w0ts/jank/hardware/box/renders/back.png

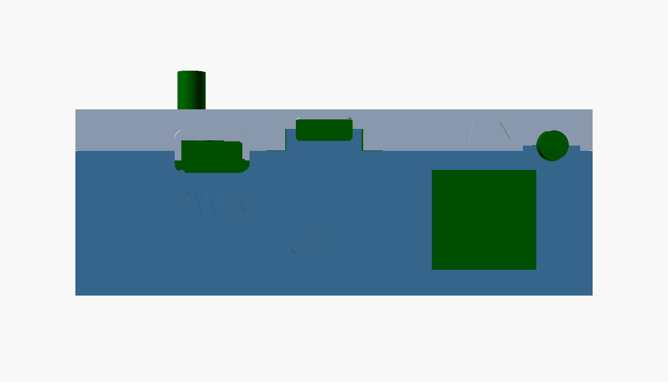
hardware/box/renders/back.png
