w0ts/jank/hardware/box/renders/box.png

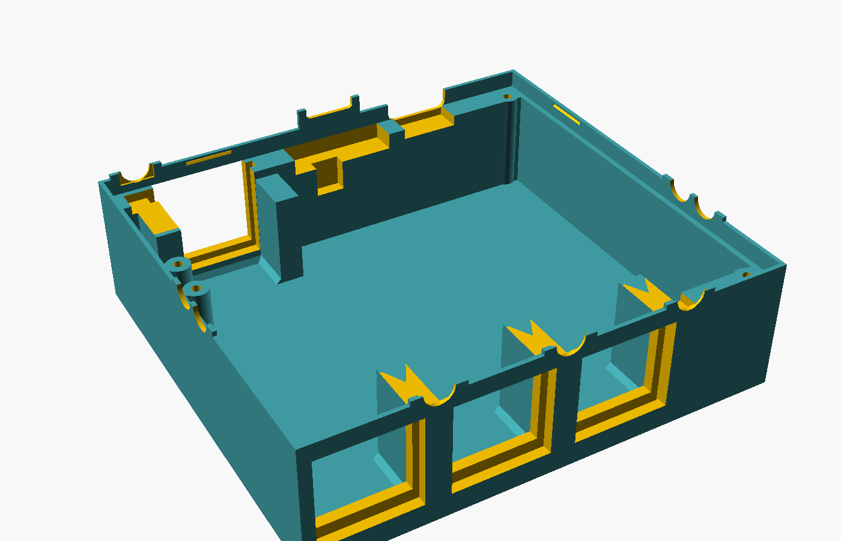
hardware/box/renders/box.png
