w0ts/jank/hardware/box/renders/caps.png

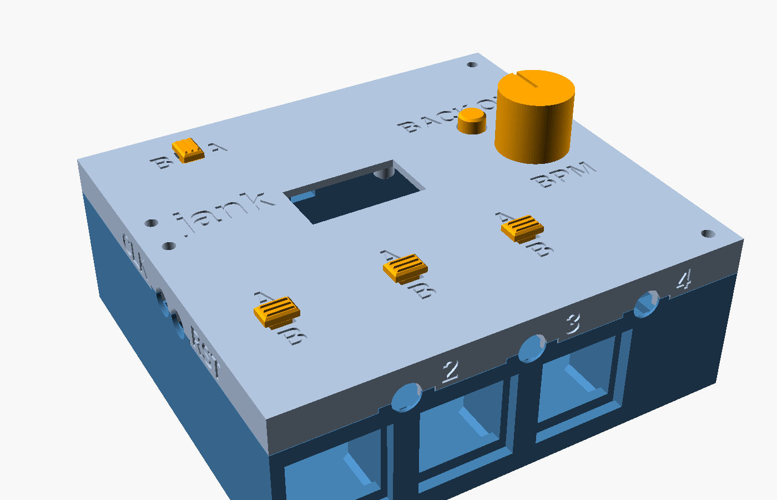
hardware/box/renders/caps.png
