w0ts/jank/hardware/box/renders/front.png

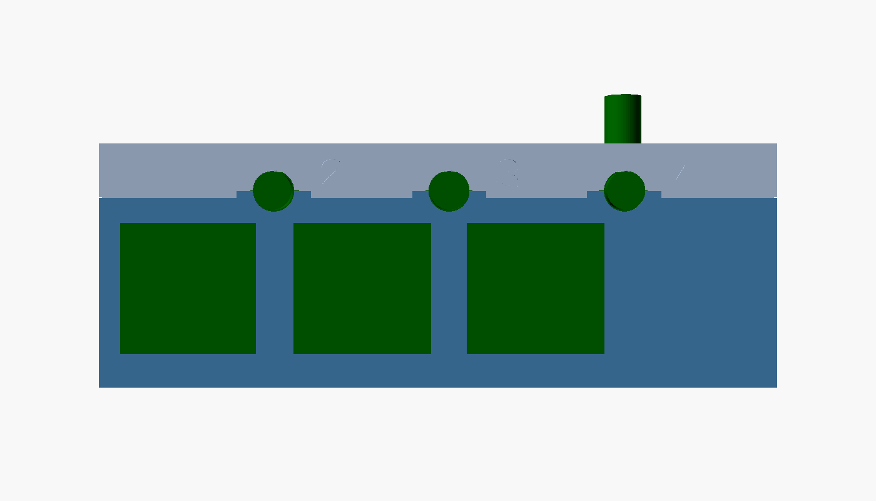
hardware/box/renders/front.png
