w0ts/jank/hardware/box/renders/joint.png

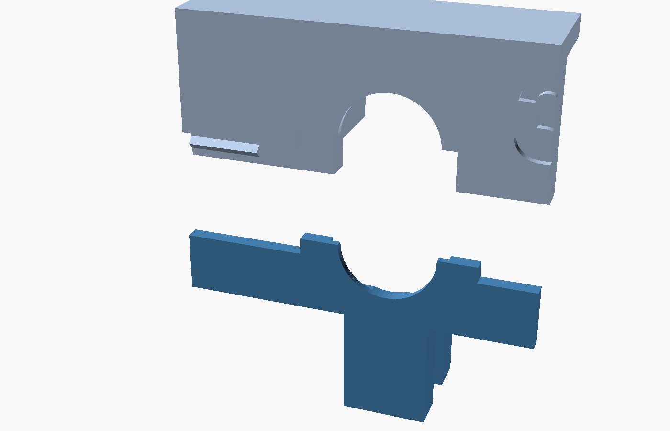
hardware/box/renders/joint.png
