w0ts/jank/hardware/box/renders/left.png

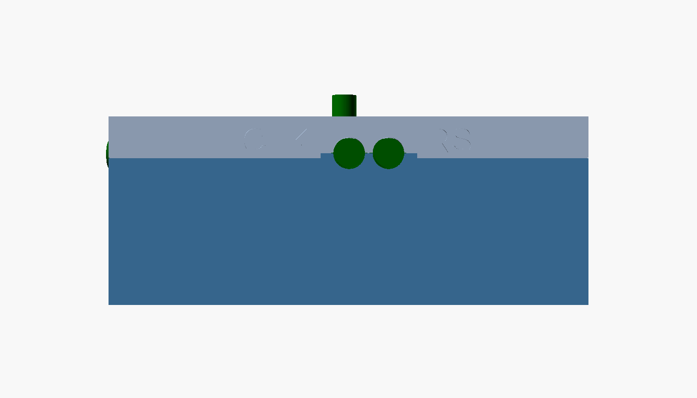
hardware/box/renders/left.png
