w0ts/jank/hardware/box/renders/lid_top.png

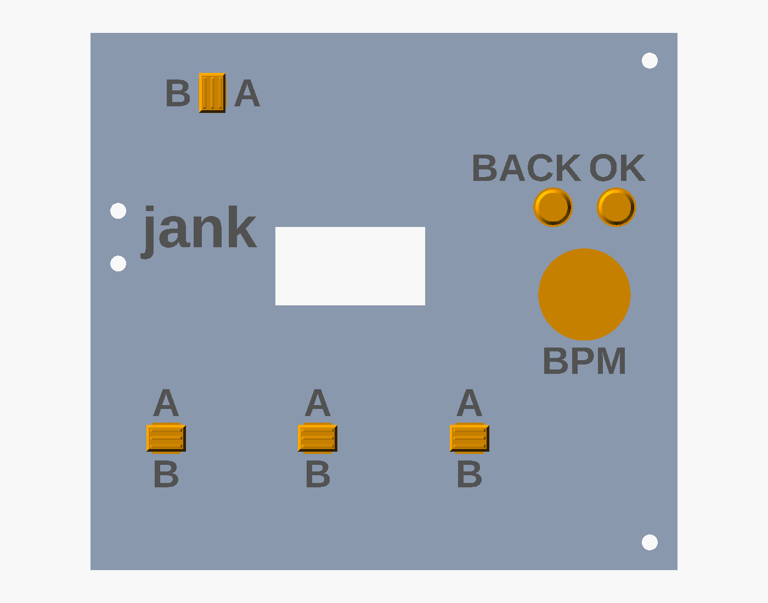
hardware/box/renders/lid_top.png
