w0ts/jank/hardware/box/renders/lid_underside.png

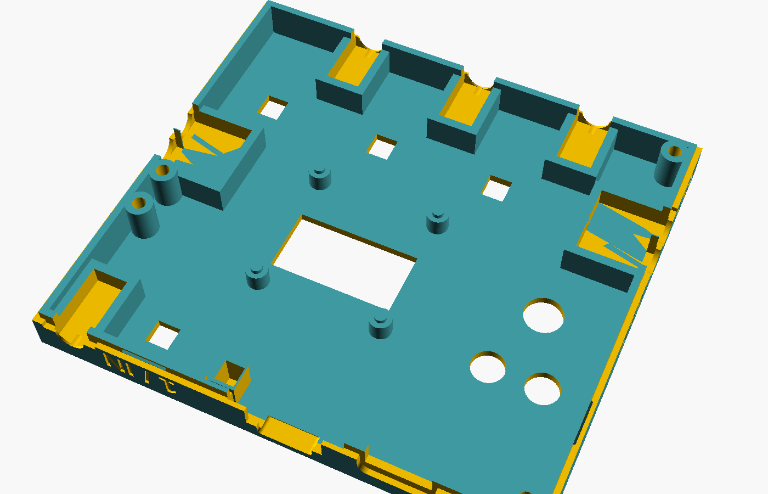
hardware/box/renders/lid_underside.png
