w0ts/jank/hardware/box/renders/right.png

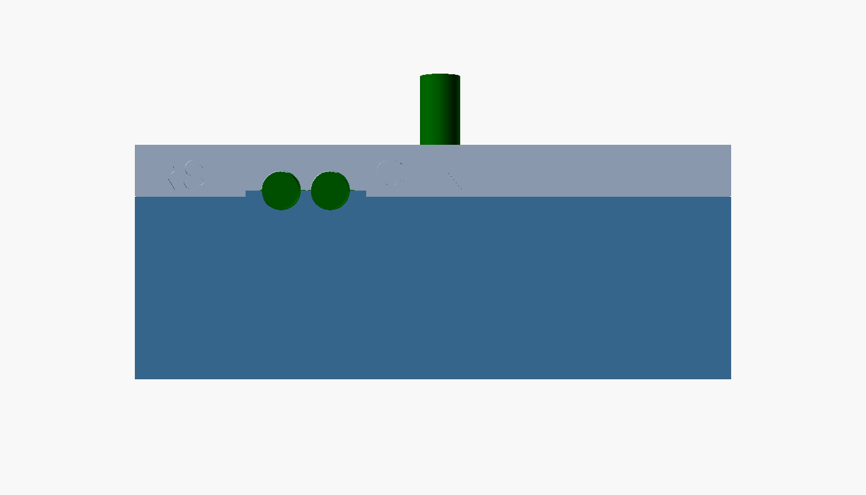
hardware/box/renders/right.png
