w0ts/jank/hardware/box/renders/tab.png

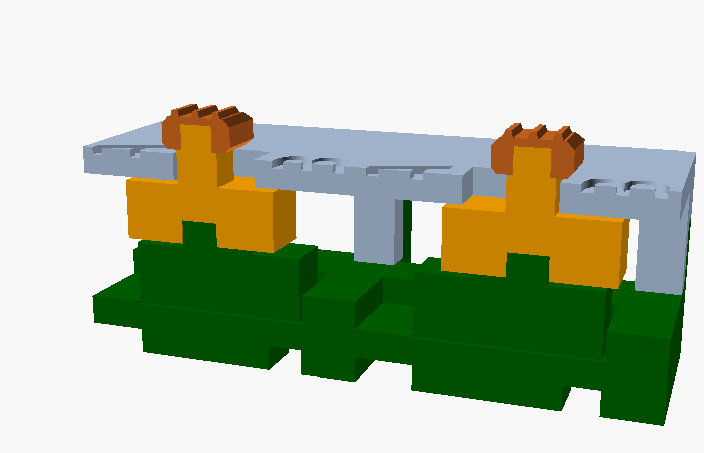
hardware/box/renders/tab.png
