w0ts/jank/hardware/pcb/render-bottom-mod.png

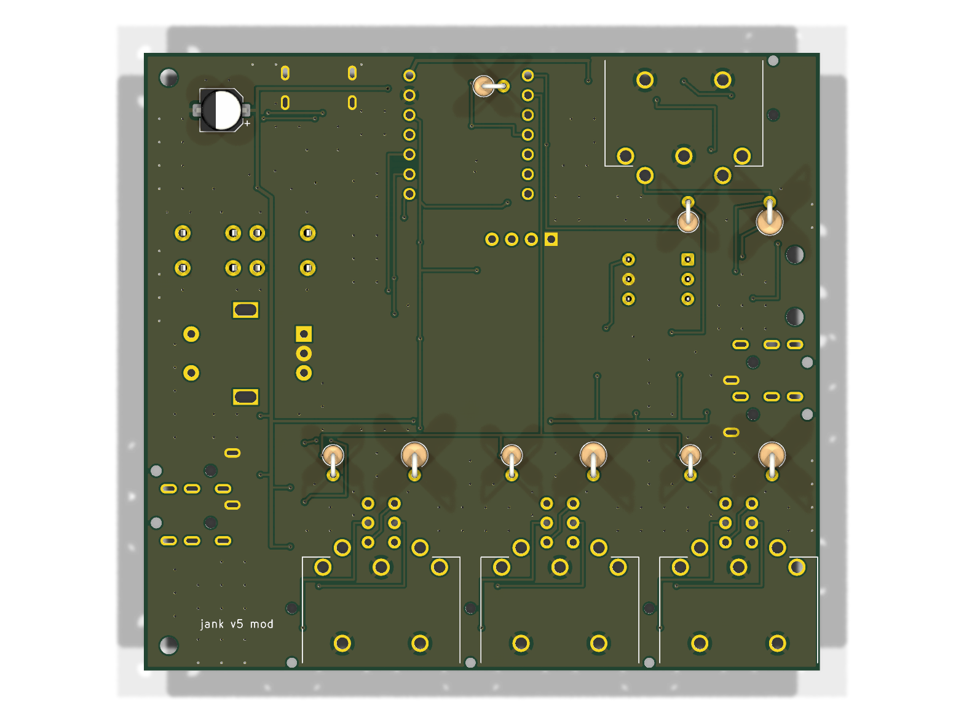
hardware/pcb/render-bottom-mod.png
