w0ts/jank/hardware/pcb/render-bottom.png

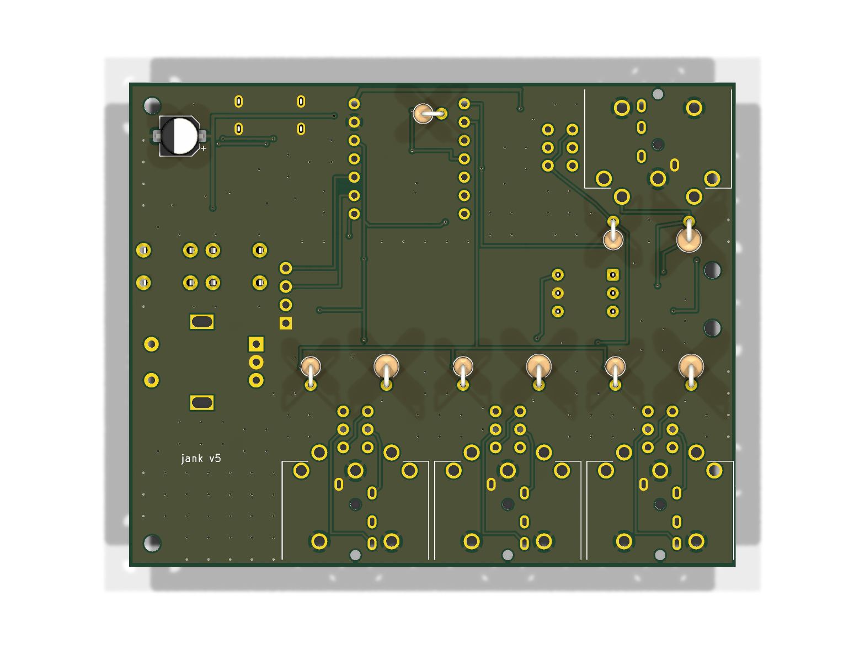
hardware/pcb/render-bottom.png
