w0ts/jank/hardware/pcb/render-top.png

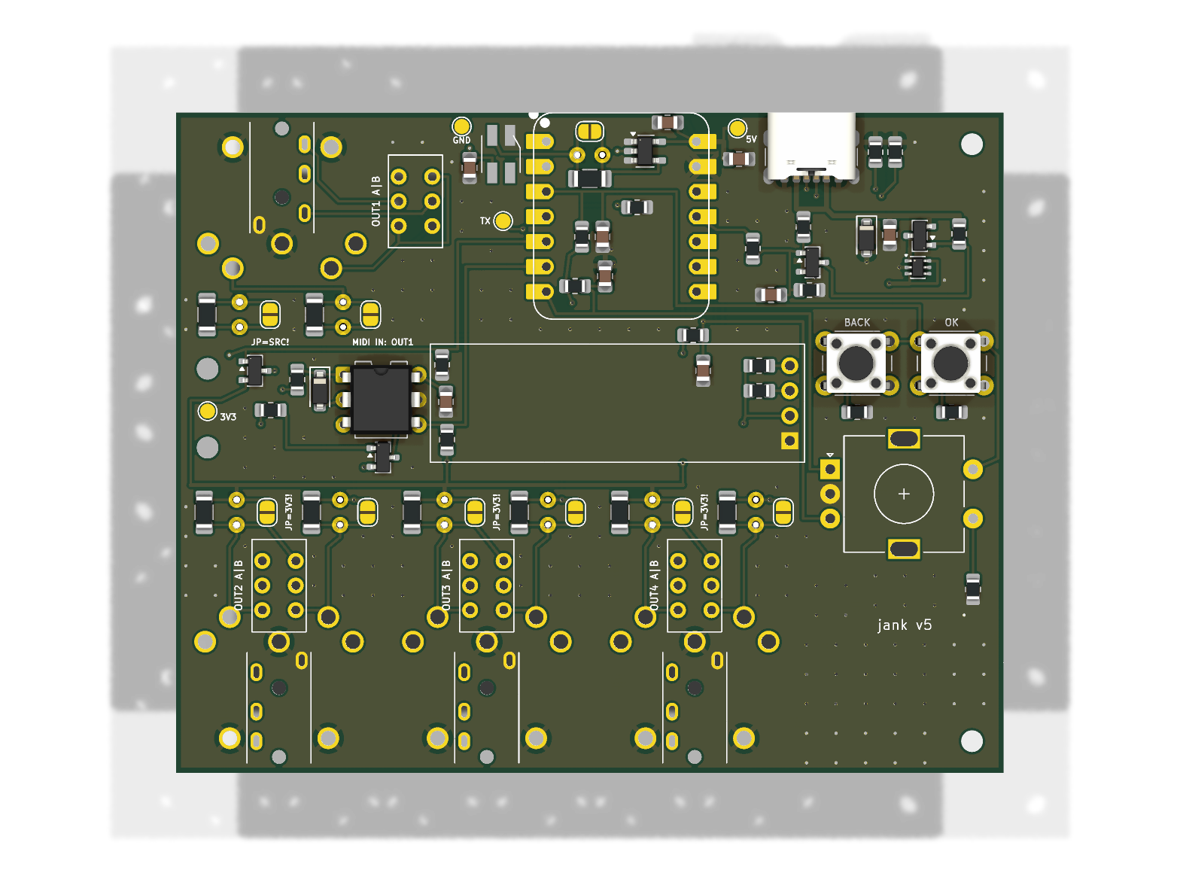
hardware/pcb/render-top.png
