w0ts/jank/hardware/pcb/BOM-mod.md

# jank board (modular variant): bill of materials

Generated by `make_schematic.py`. One price each, read on 2026-11-08 from the shop named, at its first price break, before VAT and shipping. LCSC prices come from LCSC's own product data (USD). Nothing here was ordered.

v5: every output has BOTH connectors fitted, the 3.5 mm jack on the top and the DIN-5 on the bottom (in parallel,
plug one at a time), and its TRS A/B switch. One board: 4 jacks, 4 DINs, 4 A/B switches, the OLED, one LED. **Modular variant** (`jank-pcb-mod`): plus 4 mono jacks (CLOCK / RESET, both side walls), the PCF8574T, 4 buffers, 4 x 1 k, 4 BAT54S, 5 x 100 nF.

| Refs | Qty | Part | MPN | Shop, code | Unit | Min order |
|---|---|---|---|---|---|---|
| U1 | 1 | Seeed XIAO ESP32S3 (plain, not Sense), no headers included | 113991114 | Seeed Studio seeedstudio.com XIAO-ESP32S3-p-5627 | USD 7.4900 | 1 |
| (U1) | 2 | Pin header 1x7, 2.54 mm (the XIAO's legs: parts sit under the module) | PZ254V-11-07P | LCSC C492406 | USD 0.0467 | 10 |
| J1 | 1 | USB-C receptacle, power only, 6 pins + 4 through-hole shell legs (v5c 2026-11-09: in JLC stock; the GCT USB4125 had none) | SHOU HAN TYPE-C 6P | LCSC C456012 | USD 0.0390 | 1 |
| R1, R2 | 2 | Resistor 5.1k 1% 0805 | UNI-ROYAL 0805W8F5101T5E | LCSC C27834 | USD 0.0055 | 100 |
| D1 | 1 | TVS 5.0 V unidirectional, SOD-123F | MDD SMF5.0A | LCSC C193402 | USD 0.0285 | 20 |
| C1, C3 | 2 | Capacitor 10uF 25V X5R 0805 | Samsung CL21A106KAYNNNE | LCSC C15850 | USD 0.0362 | 20 |
| Q1, Q4 | 2 | P-MOSFET 30 V 4 A, SOT-23 | AOS AO3401A | LCSC C15127 | USD 0.0835 | 5 |
| Q2, Q3 | 2 | N-MOSFET 30 V, Vgs(th) max 1.45 V (listing), SOT-23 | AOS AO3400A | LCSC C20917 | USD 0.0899 | 5 |
| R3, R4, R5, R7, R53 | 5 | Resistor 100k 1% 0805 | UNI-ROYAL 0805W8F1003T5E | LCSC C149504 | USD 0.0060 | 100 |
| R6, R52, R72, R73, R74, R75 | 6 | Resistor 1k 1% 0805 | UNI-ROYAL 0805W8F1001T5E | LCSC C17513 | USD 0.0035 | 100 |
| C2, C5, C6, C8, C9, C10, C11, C12, C13, C14, C15, C16 | 12 | Capacitor 100nF 50V X7R 0805 (JLCPCB basic part; price: JLCPCB's parts list) | YAGEO CC0805KRX7R9BB104 | LCSC C49678 | USD 0.0205 | 20 |
| U2 | 1 | Ideal diode 1.5 A, SC-70-6 (0.65 mm pitch) | TI LM66100DCKR | LCSC C2869734 | USD 0.2089 | 5 |
| R70, R71, R51, R60, R64, R65 | 6 | Resistor 10k 1% 0805 (pull-ups: the ladder, the encoder, I2C, the opto output) | UNI-ROYAL 0805W8F1002T5E | LCSC C17414 | USD 0.0034 | 100 |
| R61 | 1 | Resistor 2.2k 1% 0805 (ladder: OK) | UNI-ROYAL 0805W8F2201T5E | LCSC C17520 | USD 0.0050 | 100 |
| R62 | 1 | Resistor 6.8k 1% 0805 (ladder: BACK) | UNI-ROYAL 0805W8F6801T5E | LCSC C17772 | USD 0.0028 | 100 |
| R63 | 1 | Resistor 22k 1% 0805 (ladder: the encoder's push) | UNI-ROYAL 0805W8F2202T5E | LCSC C17560 | USD 0.0048 | 100 |
| SW7 | 1 | Rotary encoder EC11, vertical, 18 detents / 9 pulses, push switch, 20 mm flat (D) shaft, through hole, top side | ALPS EC11E09244BS | LCSC C470742 | USD 2.3275 | 1 |
| C4 | 1 (not fitted) | Electrolytic 100uF 16V 5 x 5.4 mm (not fitted by default) | ROQANG RVT1C101M0505 | LCSC C2977550 | USD 0.0356 | 20 |
| SW1, SW6 | 2 | Tactile switch 6 x 6 mm, through hole, 9.0 mm tall, top side (OK, BACK), soldered by the user (JLC refused the whole HRO K2-1102DP family for assembly on 2026-11-09); 9.0 mm: the lid's button caps 0.5 mm longer than for 9.5 | HRO K2-1102DP-K4SW-04 | LCSC C111992 | USD 0.0653 | 1 |
| U5 | 1 | I2C GPIO expander, 8 bit, quasi-bidirectional, SOIC-16 wide (the modular variant: CLOCK / RESET; price: JLCPCB's parts list) | NXP PCF8574T/3 | LCSC C7605 | USD 2.0313 | 1 |
| D3, D4, D5, D6 | 4 | Diode pair in series BAV99, SOT-23, same pinout as the BAT54S (1 = A1, 2 = K2, 3 = K1/A2): the modular outputs' clamp to GND and +5V; v5c 2026-11-09: a JLC basic part instead of the extended BAT54S (silicon, clamps at ~0.7 V instead of ~0.35 V past the rails: fine behind the 1 k) | BAV99 | LCSC C2500 | USD 0.0000 | 20 |
| U3, U6, U7, U8, U9 | 5 | Buffer 74AHCT1G125, SOT-23-5 (4.5 to 5.5 V) | TI SN74AHCT1G125DBVR | LCSC C7484 | USD 0.1009 | 5 |
| J2, J3, J4, J5 | 4 | 3.5 mm stereo jack, right angle, SURFACE MOUNT (4 tabs 1.5 x 2.5, 2 pegs 1.3), plug from the front, top side: the four MIDI outputs' jacks (J2..J5 are BOM lines; the pads are in J6..J9's footprint). Surface-mount so nothing of it goes through the board under the neighbouring DIN bodies | XKB PJ-320D-B-SMT | LCSC C2884940 | USD 0.0000 | 5 |
| SW2 | 1 | Slide switch DPDT, surface mount, 6 tabs 2.5 mm, 7.7 x 3.55 mm, knob 3.0 mm (OUT1's TRS type A / B: it sits over the DIN's body, where a through-hole switch's pins would hit it) | XKB SS-3235S-L2 | LCSC C500056 | USD 0.0000 | 5 |
| SW3, SW4, SW5 | 3 | Slide switch DPDT, 6 pins 2.5 mm, 9.1 x 3.5 mm, handle 1.5 mm (TRS type A / B), face side; OUT2..4 | SHOU HAN MSS22D18G2 | LCSC C431542 | USD 0.0996 | 5 |
| U4 | 1 | Optocoupler H11L1, Schmitt trigger, open collector, DIP-6 (MIDI IN on OUT1) | EVERLIGHT H11L1 | LCSC C78588 | USD 0.3507 | 5 |
| D2 | 1 | Diode 1N4148W, SOD-123 (the opto LED's reverse protection) | Semtech 1N4148W | LCSC C81598 | USD 0.0125 | 50 |
| R50 | 1 | Resistor 220 1% 0805 (MIDI IN, CA-033 / MIDI 1.0) | UNI-ROYAL 0805W8F2200T5E | LCSC C17557 | USD 0.0030 | 100 |
| R8, R11, R21, R12, R22, R13, R23, R14, R24 | 9 (not fitted) | Axial pads, not fitted (a bench fix: an axial resistor in place of the 1206s, with them removed) | - | - - | USD 0.0000 | 0 |
| R31 | 1 | Resistor 47 ohm 1% 0.25 W 1206 (OUT1's RC: OUT1 doubles as MIDI IN) | UNI-ROYAL 1206W4F470JT5E | LCSC C17969 | USD 0.0053 | 1 |
| R32, R33, R34 | 3 | Resistor 10 ohm 1% 0.25 W 1206 (RC, data) | UNI-ROYAL 1206W4F100JT5E | LCSC C17903 | USD 0.0027 | 100 |
| R41, R81, R42, R82, R43, R83, R44, R84 | 8 | Resistor 100 ohm 1% 0.25 W 1206, two in parallel = the 50 ohm source RA (0.5 W together; v5c 2026-11-09: 100 ohm is a JLC basic part, 68 is not; the loop current ~5.9 mA instead of ~6.8 mA) | UNI-ROYAL 1206W4F1000T5E | LCSC C17901 | USD 0.0000 | 100 |
| R9 | 1 | Resistor 300 ohm 1% 0.25 W 1206 (the LED's data; 300 is a JLC basic part, 330 is not) | UNI-ROYAL 1206W4F3000T5E | LCSC C17887 | USD 0.0000 | 100 |
| LED1 | 1 | RGB LED, addressable, 3.7 x 3.5 x 1.95 mm, top emitting (the beat LED) | OPSCO SK6812MINI-HS | LCSC C2922787 | USD 0.1085 | 5 |
| J10 | 1 | OLED module 0.96 in 128 x 64, white, SSD1315 (SSD1306 commands), I2C, 27.3 x 27.8 mm, 4 holes 2.54 mm (GND VCC SCL SDA) | HS HS96L03W2C03 | LCSC C5248080 | USD 0.0000 | 1 |
| (J10) | 1 | Pin header 1x4, 2.54 mm (the OLED module's legs) | XFCN PZ254V-11-04P | LCSC C2691448 | USD 0.0276 | 20 |
| J11, J12, J13, J14 | 4 | 3.5 mm stereo jack, right angle, plug from the front, 4 pins (its switch pin left open), top side | XKB PJ-320A | LCSC C2884926 | USD 0.1458 | 5 |
| J6, J7, J8, J9 | 4 | DIN-5 180 degree, PCB right angle, 7 pins, no locating pegs, bottom side | HOOYA DIN-504B-M10 | LCSC C2939346 | USD 0.3764 | 5 |

Test points TP1 to TP4 and the bypass jumpers JP8, JP11 to JP24 are bare pads, not parts.

## Total, one board

| Build | Parts at unit price | With each shop's minimum order |
|---|---|---|
| 4 jacks + 4 DINs + 4 A/B switches, OLED, 1 LED + the modular outputs | USD 16.52 | USD 26.86 |

USD: LCSC and Seeed (the XIAO). The bare board is ordered at JLCPCB with another board and is not in these totals.
