w0ts/jank/hardware/pcb/BOM.md

# jank board: bill of materials

Generated by `make_schematic.py`. One price each, read on 2026-11-08 from the shop named, at its first price break, before VAT and shipping. LCSC prices come from LCSC's own product data (USD). Nothing here was ordered.

v5: every output has BOTH connectors fitted, the 3.5 mm jack on the top and the DIN-5 on the bottom (in parallel,
plug one at a time), and its TRS A/B switch. One board: 4 jacks, 4 DINs, 4 A/B switches, the OLED, one LED.

| Refs | Qty | Part | MPN | Shop, code | Unit | Min order |
|---|---|---|---|---|---|---|
| U1 | 1 | Seeed XIAO ESP32S3 (plain, not Sense), no headers included | 113991114 | Seeed Studio seeedstudio.com XIAO-ESP32S3-p-5627 | USD 7.4900 | 1 |
| (U1) | 2 | Pin header 1x7, 2.54 mm (the XIAO's legs: parts sit under the module) | PZ254V-11-07P | LCSC C492406 | USD 0.0467 | 10 |
| J1 | 1 | USB-C receptacle, power only, 6 pins + 4 through-hole shell legs | GCT USB4125-GF-A-0190 | LCSC C5246813 | USD 0.9178 | 1 |
| R1, R2 | 2 | Resistor 5.1k 1% 0805 | UNI-ROYAL 0805W8F5101T5E | LCSC C27834 | USD 0.0055 | 100 |
| D1 | 1 | TVS 5.0 V unidirectional, SOD-123F | MDD SMF5.0A | LCSC C193402 | USD 0.0285 | 20 |
| C1, C3 | 2 | Capacitor 10uF 25V X5R 0805 | Samsung CL21A106KAYNNNE | LCSC C15850 | USD 0.0362 | 20 |
| Q1, Q4 | 2 | P-MOSFET 30 V 4 A, SOT-23 | AOS AO3401A | LCSC C15127 | USD 0.0835 | 5 |
| Q2, Q3 | 2 | N-MOSFET 30 V, Vgs(th) max 1.45 V (listing), SOT-23 | AOS AO3400A | LCSC C20917 | USD 0.0899 | 5 |
| R3, R4, R5, R7, R53 | 5 | Resistor 100k 1% 0805 | UNI-ROYAL 0805W8F1003T5E | LCSC C149504 | USD 0.0060 | 100 |
| R6, R52 | 2 | Resistor 1k 1% 0805 | UNI-ROYAL 0805W8F1001T5E | LCSC C17513 | USD 0.0035 | 100 |
| C2, C5, C6, C8, C9, C10, C11 | 7 | Capacitor 100nF 50V X7R 0805 (JLCPCB basic part; price: JLCPCB's parts list) | YAGEO CC0805KRX7R9BB104 | LCSC C49678 | USD 0.0205 | 20 |
| U2 | 1 | Ideal diode 1.5 A, SC-70-6 (0.65 mm pitch) | TI LM66100DCKR | LCSC C2869734 | USD 0.2089 | 5 |
| R70, R71, R51, R60, R64, R65 | 6 | Resistor 10k 1% 0805 (pull-ups: the ladder, the encoder, I2C, the opto output) | UNI-ROYAL 0805W8F1002T5E | LCSC C17414 | USD 0.0034 | 100 |
| R61 | 1 | Resistor 2.2k 1% 0805 (ladder: OK) | UNI-ROYAL 0805W8F2201T5E | LCSC C17520 | USD 0.0050 | 100 |
| R62 | 1 | Resistor 6.8k 1% 0805 (ladder: BACK) | UNI-ROYAL 0805W8F6801T5E | LCSC C17772 | USD 0.0028 | 100 |
| R63 | 1 | Resistor 22k 1% 0805 (ladder: the encoder's push) | UNI-ROYAL 0805W8F2202T5E | LCSC C17560 | USD 0.0048 | 100 |
| SW7 | 1 | Rotary encoder EC11, vertical, 18 detents / 9 pulses, push switch, 20 mm flat (D) shaft, through hole, top side | ALPS EC11E09244BS | LCSC C470742 | USD 2.3275 | 1 |
| C4 | 1 (not fitted) | Electrolytic 100uF 16V 5 x 5.4 mm (not fitted by default) | ROQANG RVT1C101M0505 | LCSC C2977550 | USD 0.0356 | 20 |
| SW1, SW6 | 2 | Tactile switch 6 x 6 mm, through hole, 9.5 mm tall, top side (OK, BACK) | HRO K2-1102DP-L3SW-04 | LCSC C445493 | USD 0.0633 | 10 |
| U3 | 1 | Buffer 74AHCT1G125, SOT-23-5 (4.5 to 5.5 V) | TI SN74AHCT1G125DBVR | LCSC C7484 | USD 0.1009 | 5 |
| SW2, SW3, SW4, SW5 | 4 | Slide switch DPDT, 6 pins 2.5 mm, 9.1 x 3.5 mm, handle 1.5 mm (TRS type A / B), face side; one per output | SHOU HAN MSS22D18G2 | LCSC C431542 | USD 0.0996 | 5 |
| U4 | 1 | Optocoupler H11L1, Schmitt trigger, open collector, DIP-6 (MIDI IN on OUT1) | EVERLIGHT H11L1 | LCSC C78588 | USD 0.3507 | 5 |
| D2 | 1 | Diode 1N4148W, SOD-123 (the opto LED's reverse protection) | Semtech 1N4148W | LCSC C81598 | USD 0.0125 | 50 |
| R50 | 1 | Resistor 220 1% 0805 (MIDI IN, CA-033 / MIDI 1.0) | UNI-ROYAL 0805W8F2200T5E | LCSC C17557 | USD 0.0030 | 100 |
| R8 | 1 | Resistor 330 1% 0.25 W axial (6.3 x 2.4 mm), standing | YAGEO MFR-25FBF52-330R | LCSC C1369900 | USD 0.0205 | 50 |
| R9, R31, R41, R32, R42, R33, R43, R34, R44 | 9 (not fitted) | 1206 pads in parallel, not fitted (to lower a value on the bench) | - | - - | USD 0.0000 | 0 |
| LED1 | 1 | RGB LED, addressable, 3.7 x 3.5 x 1.95 mm, top emitting (the beat LED) | OPSCO SK6812MINI-HS | LCSC C2922787 | USD 0.1085 | 5 |
| J10 | 1 | OLED module 0.91 in 128 x 32, SSD1306, I2C, 38 x 12 mm, 4 holes 2.54 mm (GND VCC SCL SDA) | HS HS91L02W2C01 | LCSC C5248081 | USD 2.3670 | 1 |
| (J10) | 1 | Pin header 1x4, 2.54 mm (the OLED module's legs) | XFCN PZ254V-11-04P | LCSC C2691448 | USD 0.0276 | 20 |
| R11, R12, R13, R14 | 4 | Resistor 10 ohm 1% 0.25 W axial (6.3 x 2.4 mm), standing (RC, data) | YAGEO MFR-25FBF52-10R | LCSC C1365579 | USD 0.0205 | 50 |
| R21, R22, R23, R24 | 4 | Resistor 33 ohm 1% 0.5 W axial (9 x 3.2 mm), standing (RA, source) | CCO MF1/2W-33R 1% T | LCSC C119401 | USD 0.0241 | 20 |
| J2, J3, J4, J5 | 4 | 3.5 mm stereo jack, right angle, plug from the front, 4 pins (its switch pin left open), top side | XKB PJ-320A | LCSC C2884926 | USD 0.1458 | 5 |
| J6, J7, J8, J9 | 4 | DIN-5 180 degree, PCB right angle, 7 pins, no locating pegs, bottom side | HOOYA DIN-504B-M10 | LCSC C2939346 | USD 0.3764 | 5 |

Test points TP1 to TP4 and the bypass jumpers JP8, JP11 to JP24 are bare pads, not parts.

## Total, one board

| Build | Parts at unit price | With each shop's minimum order |
|---|---|---|
| 4 jacks + 4 DINs + 4 A/B switches, OLED, 1 LED | USD 17.49 | USD 30.84 |

USD: LCSC and Seeed (the XIAO). The bare board is ordered at JLCPCB with another board and is not in these totals.
