w0ts/jank/hardware/pcb/fab/bom.csv

Comment | Designator | Footprint | LCSC Part #
10uF | C1,C3 | C_0805_2012Metric_Pad1.18x1.45mm_HandSolder | C15850
100nF | C2,C5,C6,C8,C9,C10,C11 | C_0805_2012Metric_Pad1.18x1.45mm_HandSolder | C49678
SMF5.0A | D1 | D_SOD-123F | C193402
1N4148W | D2 | D_SOD-123 | C81598
SK6812MINI-HS | LED1 | LED_SK6812MINI-HS_3.7x3.5mm_HandSolder | C2922787
AO3401A | Q1,Q4 | SOT-23 | C15127
AO3400A | Q2,Q3 | SOT-23 | C20917
5.1k | R1,R2 | R_0805_2012Metric_Pad1.20x1.40mm_HandSolder | C27834
100k | R3,R4,R5,R7,R53 | R_0805_2012Metric_Pad1.20x1.40mm_HandSolder | C149504
1k | R6,R52 | R_0805_2012Metric_Pad1.20x1.40mm_HandSolder | C17513
220 | R50 | R_0805_2012Metric_Pad1.20x1.40mm_HandSolder | C17557
10k | R51,R60,R64,R65,R70,R71 | R_0805_2012Metric_Pad1.20x1.40mm_HandSolder | C17414
2.2k | R61 | R_0805_2012Metric_Pad1.20x1.40mm_HandSolder | C17520
6.8k | R62 | R_0805_2012Metric_Pad1.20x1.40mm_HandSolder | C17772
22k | R63 | R_0805_2012Metric_Pad1.20x1.40mm_HandSolder | C17560
LM66100 | U2 | SOT-363_SC-70-6 | C2869734
74AHCT1G125 | U3 | SOT-23-5_HandSoldering | C7484
