w0ts/jank/hardware/pcb/fab/mod/bom.csv

Comment | Designator | Footprint | LCSC Part #
10uF | C1,C3 | C_0805_2012Metric_Pad1.18x1.45mm_HandSolder | C15850
100nF | C2,C5,C6,C8,C9,C10,C11,C12,C13,C14,C15,C16 | C_0805_2012Metric_Pad1.18x1.45mm_HandSolder | C49678
SMF5.0A | D1 | D_SOD-123F | C193402
1N4148W | D2 | D_SOD-123 | C81598
BAV99 | D3,D4,D5,D6 | SOT-23 | C2500
USB-C power | J1 | USB_C_SHOUHAN_TYPE-C-6P | C456012
PJ-320D-B-SMT | J2,J3,J4,J5 | PJ-320D-B-SMT | C2884940
PJ-320A mono | J11,J12,J13,J14 | Jack_3.5mm_XKB_PJ-320A_Horizontal | C2884926
SK6812MINI-HS | LED1 | LED_SK6812MINI-HS_3.7x3.5mm_HandSolder | C2922787
AO3401A | Q1,Q4 | SOT-23 | C15127
AO3400A | Q2,Q3 | SOT-23 | C20917
5.1k | R1,R2 | R_0805_2012Metric_Pad1.20x1.40mm_HandSolder | C27834
100k | R3,R4,R5,R7,R53 | R_0805_2012Metric_Pad1.20x1.40mm_HandSolder | C149504
1k | R6,R52,R72,R73,R74,R75 | R_0805_2012Metric_Pad1.20x1.40mm_HandSolder | C17513
300 | R9 | R_1206_3216Metric_Pad1.30x1.75mm_HandSolder | C17887
47 | R31 | R_1206_3216Metric_Pad1.30x1.75mm_HandSolder | C17969
10 | R32,R33,R34 | R_1206_3216Metric_Pad1.30x1.75mm_HandSolder | C17903
100 | R41,R42,R43,R44,R81,R82,R83,R84 | R_1206_3216Metric_Pad1.30x1.75mm_HandSolder | C17901
220 | R50 | R_0805_2012Metric_Pad1.20x1.40mm_HandSolder | C17557
10k | R51,R60,R64,R65,R70,R71 | R_0805_2012Metric_Pad1.20x1.40mm_HandSolder | C17414
2.2k | R61 | R_0805_2012Metric_Pad1.20x1.40mm_HandSolder | C17520
6.8k | R62 | R_0805_2012Metric_Pad1.20x1.40mm_HandSolder | C17772
22k | R63 | R_0805_2012Metric_Pad1.20x1.40mm_HandSolder | C17560
TRS A/B | SW2 | SW_Slide_DPDT_SS3235S_SMD | C500056
TRS A/B | SW3,SW4,SW5 | SW_Slide_DPDT_MSS22D18 | C431542
EC11E09244BS | SW7 | RotaryEncoder_Alps_EC11E-Switch_Vertical_H20mm | C470742
Pin header 1x7 | U1H1,U1H2 | PinHeader_1x07_P2.54mm_Vertical | C492406
LM66100 | U2 | SOT-363_SC-70-6 | C2869734
74AHCT1G125 | U3,U6,U7,U8,U9 | SOT-23-5_HandSoldering | C7484
H11L1 | U4 | DIP-6_W7.62mm | C78588
PCF8574T | U5 | SOIC-16W_7.5x10.3mm_P1.27mm | C7605
