w0ts/jank/hardware/pcb/fab/full/bom.csv

Comment | Designator | Footprint | LCSC Part #
10uF | C1,C3 | C_0805_2012Metric_Pad1.18x1.45mm_HandSolder | C15850
100nF | C2,C5,C6,C8,C9,C10,C11 | C_0805_2012Metric_Pad1.18x1.45mm_HandSolder | C49678
SMF5.0A | D1 | D_SOD-123F | C193402
1N4148W | D2 | D_SOD-123 | C81598
USB-C power | J1 | USB_C_Receptacle_GCT_USB4125-xx-x-0190_6P_TopMnt_Horizontal | C5246813
OLED 0.91in 128x32 | J10 | OLED_0.91in_128x32_I2C_HS91L02W2C01 | C5248081
Pin header 1x4 | J10H | PinHeader_1x04_P2.54mm_Vertical | C2691448
SK6812MINI-HS | LED1 | LED_SK6812MINI-HS_3.7x3.5mm_HandSolder | C2922787
AO3401A | Q1,Q4 | SOT-23 | C15127
AO3400A | Q2,Q3 | SOT-23 | C20917
5.1k | R1,R2 | R_0805_2012Metric_Pad1.20x1.40mm_HandSolder | C27834
100k | R3,R4,R5,R7,R53 | R_0805_2012Metric_Pad1.20x1.40mm_HandSolder | C149504
1k | R6,R52 | R_0805_2012Metric_Pad1.20x1.40mm_HandSolder | C17513
220 | R50 | R_0805_2012Metric_Pad1.20x1.40mm_HandSolder | C17557
10k | R51,R60,R64,R65,R70,R71 | R_0805_2012Metric_Pad1.20x1.40mm_HandSolder | C17414
2.2k | R61 | R_0805_2012Metric_Pad1.20x1.40mm_HandSolder | C17520
6.8k | R62 | R_0805_2012Metric_Pad1.20x1.40mm_HandSolder | C17772
22k | R63 | R_0805_2012Metric_Pad1.20x1.40mm_HandSolder | C17560
OK 9.5 mm | SW1 | SW_PUSH_6mm | C445493
TRS A/B | SW2,SW3,SW4,SW5 | SW_Slide_DPDT_MSS22D18 | C431542
BACK 9.5 mm | SW6 | SW_PUSH_6mm | C445493
EC11E09244BS | SW7 | RotaryEncoder_Alps_EC11E-Switch_Vertical_H20mm | C470742
Pin header 1x7 | U1H1,U1H2 | PinHeader_1x07_P2.54mm_Vertical | C492406
LM66100 | U2 | SOT-363_SC-70-6 | C2869734
74AHCT1G125 | U3 | SOT-23-5_HandSoldering | C7484
H11L1 | U4 | DIP-6_W7.62mm | C78588
