w0ts/jank/hardware/box/stl/jank_box_ab_tab_smd.stl

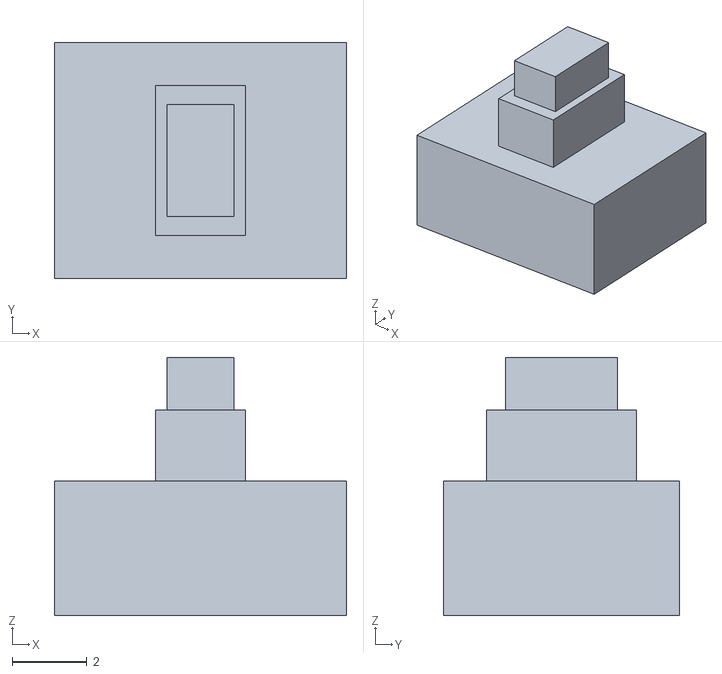
[picture p18: CAD file, 2026-11-09]
hardware/box/stl/jank_box_ab_tab_smd.stl
7.80 x 6.30 x 6.90
