w0ts/jank/hardware/pcb/mockup-mod.stl

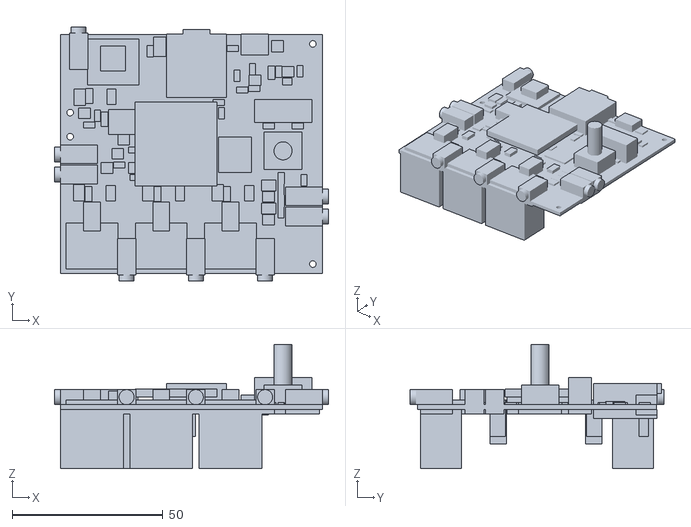
[picture p19: CAD file, 2026-11-09]
hardware/pcb/mockup-mod.stl
91.0 x 84.5 x 41.2
