w0ts/jank/hardware/box/stl/jank_box_lid.stl

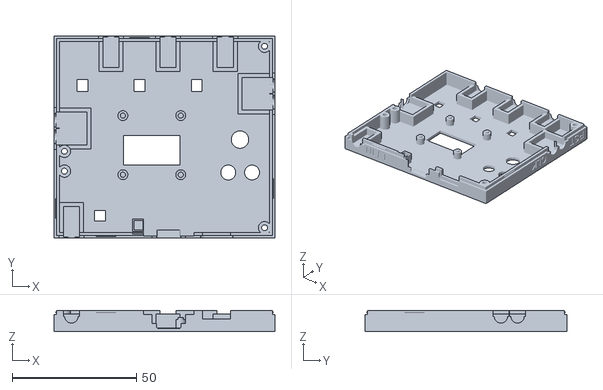
[picture p20: CAD file, 2026-11-09]
hardware/box/stl/jank_box_lid.stl
89.0 x 81.5 x 8.65
