w0ts/jank/hardware/pcb/mockup.stl

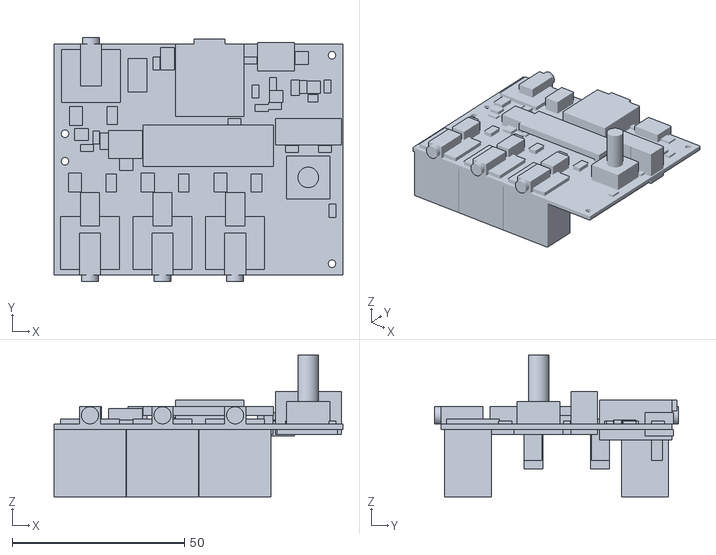
[picture p21: CAD file, 2026-11-08]
hardware/pcb/mockup.stl
84.0 x 71.0 x 41.2
