w0ts/jank/hardware/box/stl/jank_box_ab_tab.stl

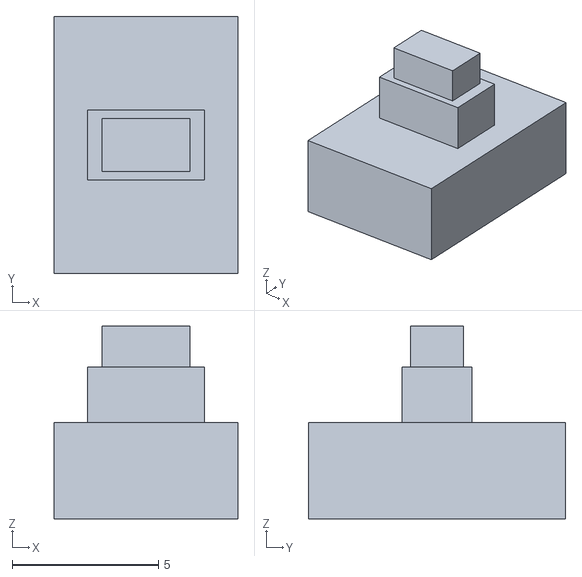
[picture p22: CAD file, 2026-11-09]
hardware/box/stl/jank_box_ab_tab.stl
6.30 x 8.80 x 6.60
