w0ts/jank/hardware/box/stl/jank_box_ab_grip.stl

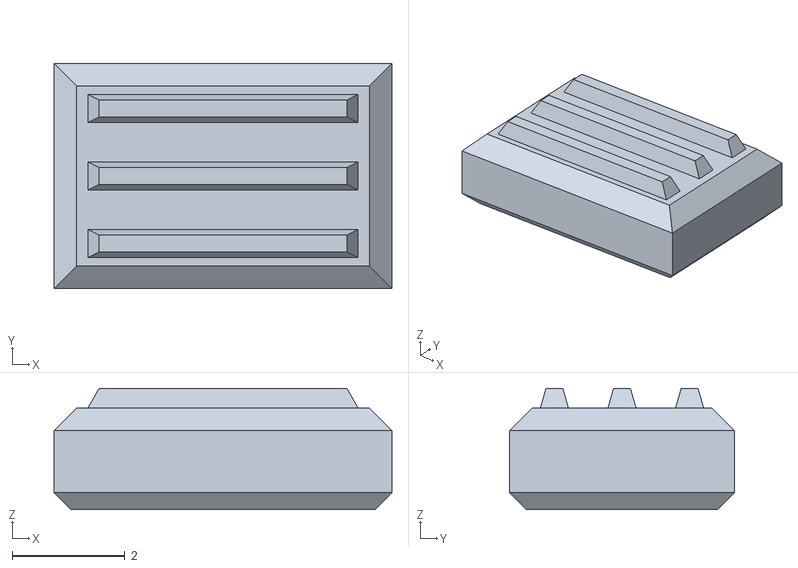
[picture p23: CAD file, 2026-11-09]
hardware/box/stl/jank_box_ab_grip.stl
6.00 x 4.00 x 2.15
