w0ts/jank/hardware/box/stl/jank_box_front_test.stl

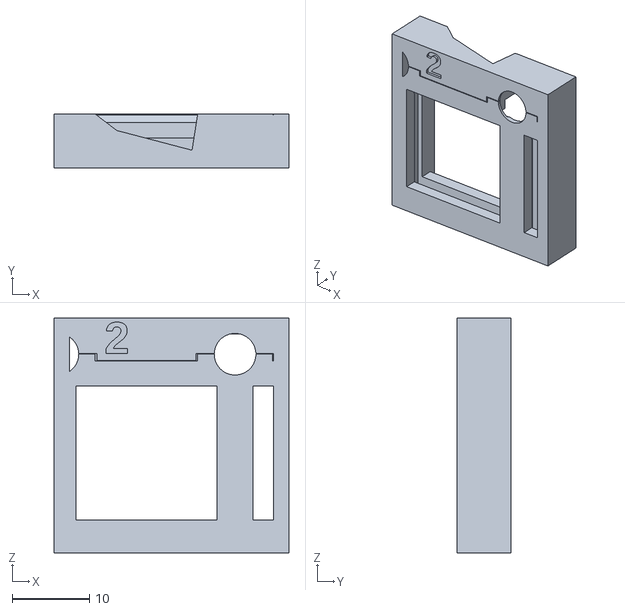
[picture p24: CAD file, 2026-11-09]
hardware/box/stl/jank_box_front_test.stl
30.5 x 7.00 x 30.5
