w0ts/jank/hardware/box/stl/jank_box_box.stl

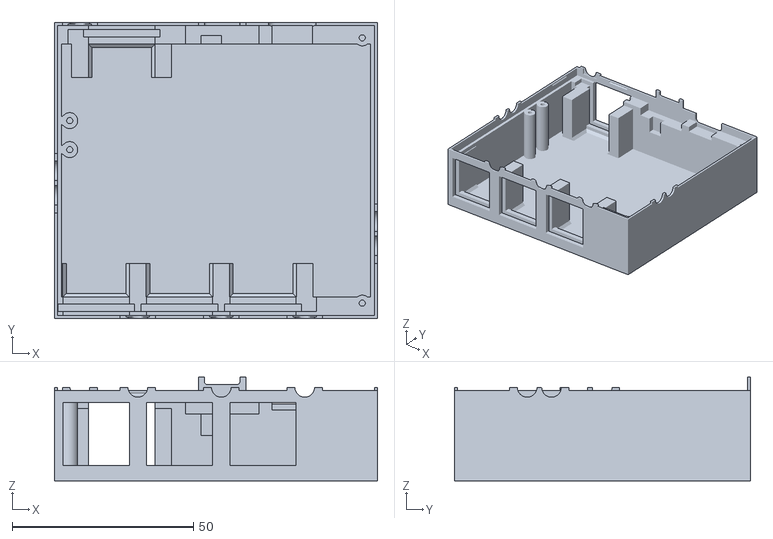
[picture p25: CAD file, 2026-11-09]
hardware/box/stl/jank_box_box.stl
89.0 x 81.5 x 28.7
