w0ts/jank/hardware/box/stl/jank_box_button_cap.stl

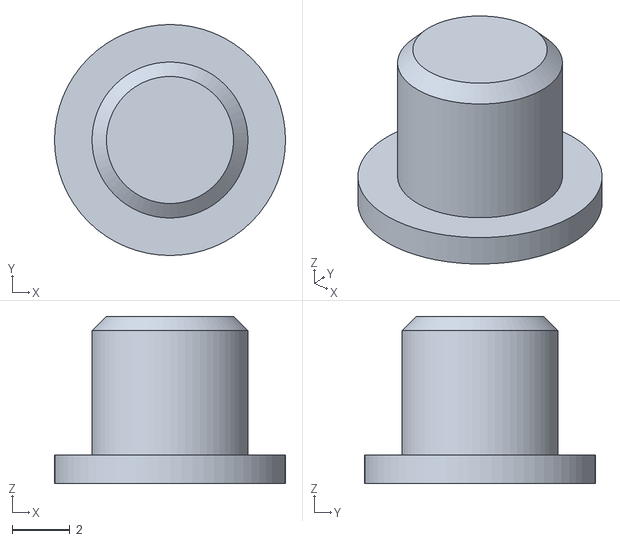
[picture p26: CAD file, 2026-11-09]
hardware/box/stl/jank_box_button_cap.stl
8.00 x 8.00 x 5.80
