w0ts/jank/hardware/box/stl/jank_box_knob.stl

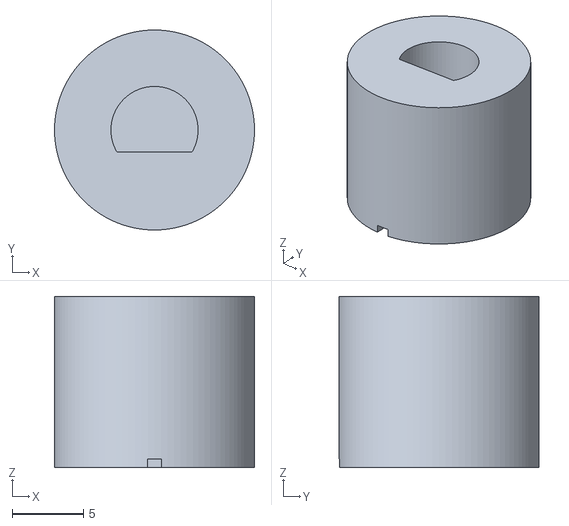
[picture p27: CAD file, 2026-11-08]
hardware/box/stl/jank_box_knob.stl
14.0 x 14.0 x 12.0
