w0ts/jank/hardware/box/renders/tab_print.png

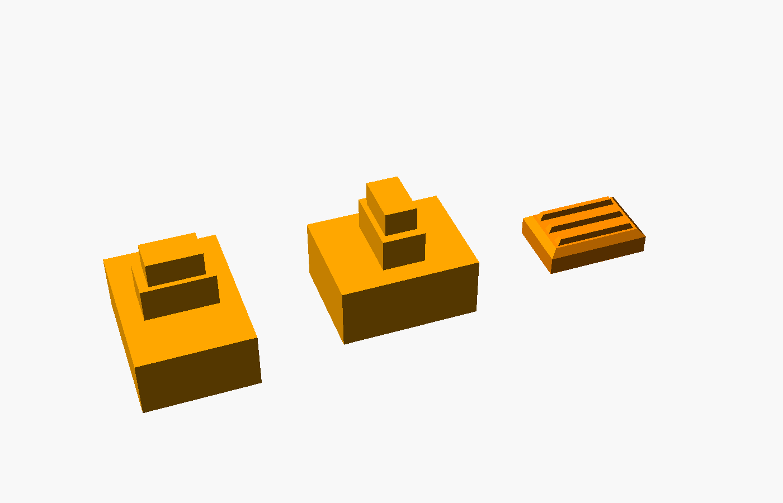
hardware/box/renders/tab_print.png
