w0ts/jank/hardware/pcb/jank-pcb-mod-schematic.pdf

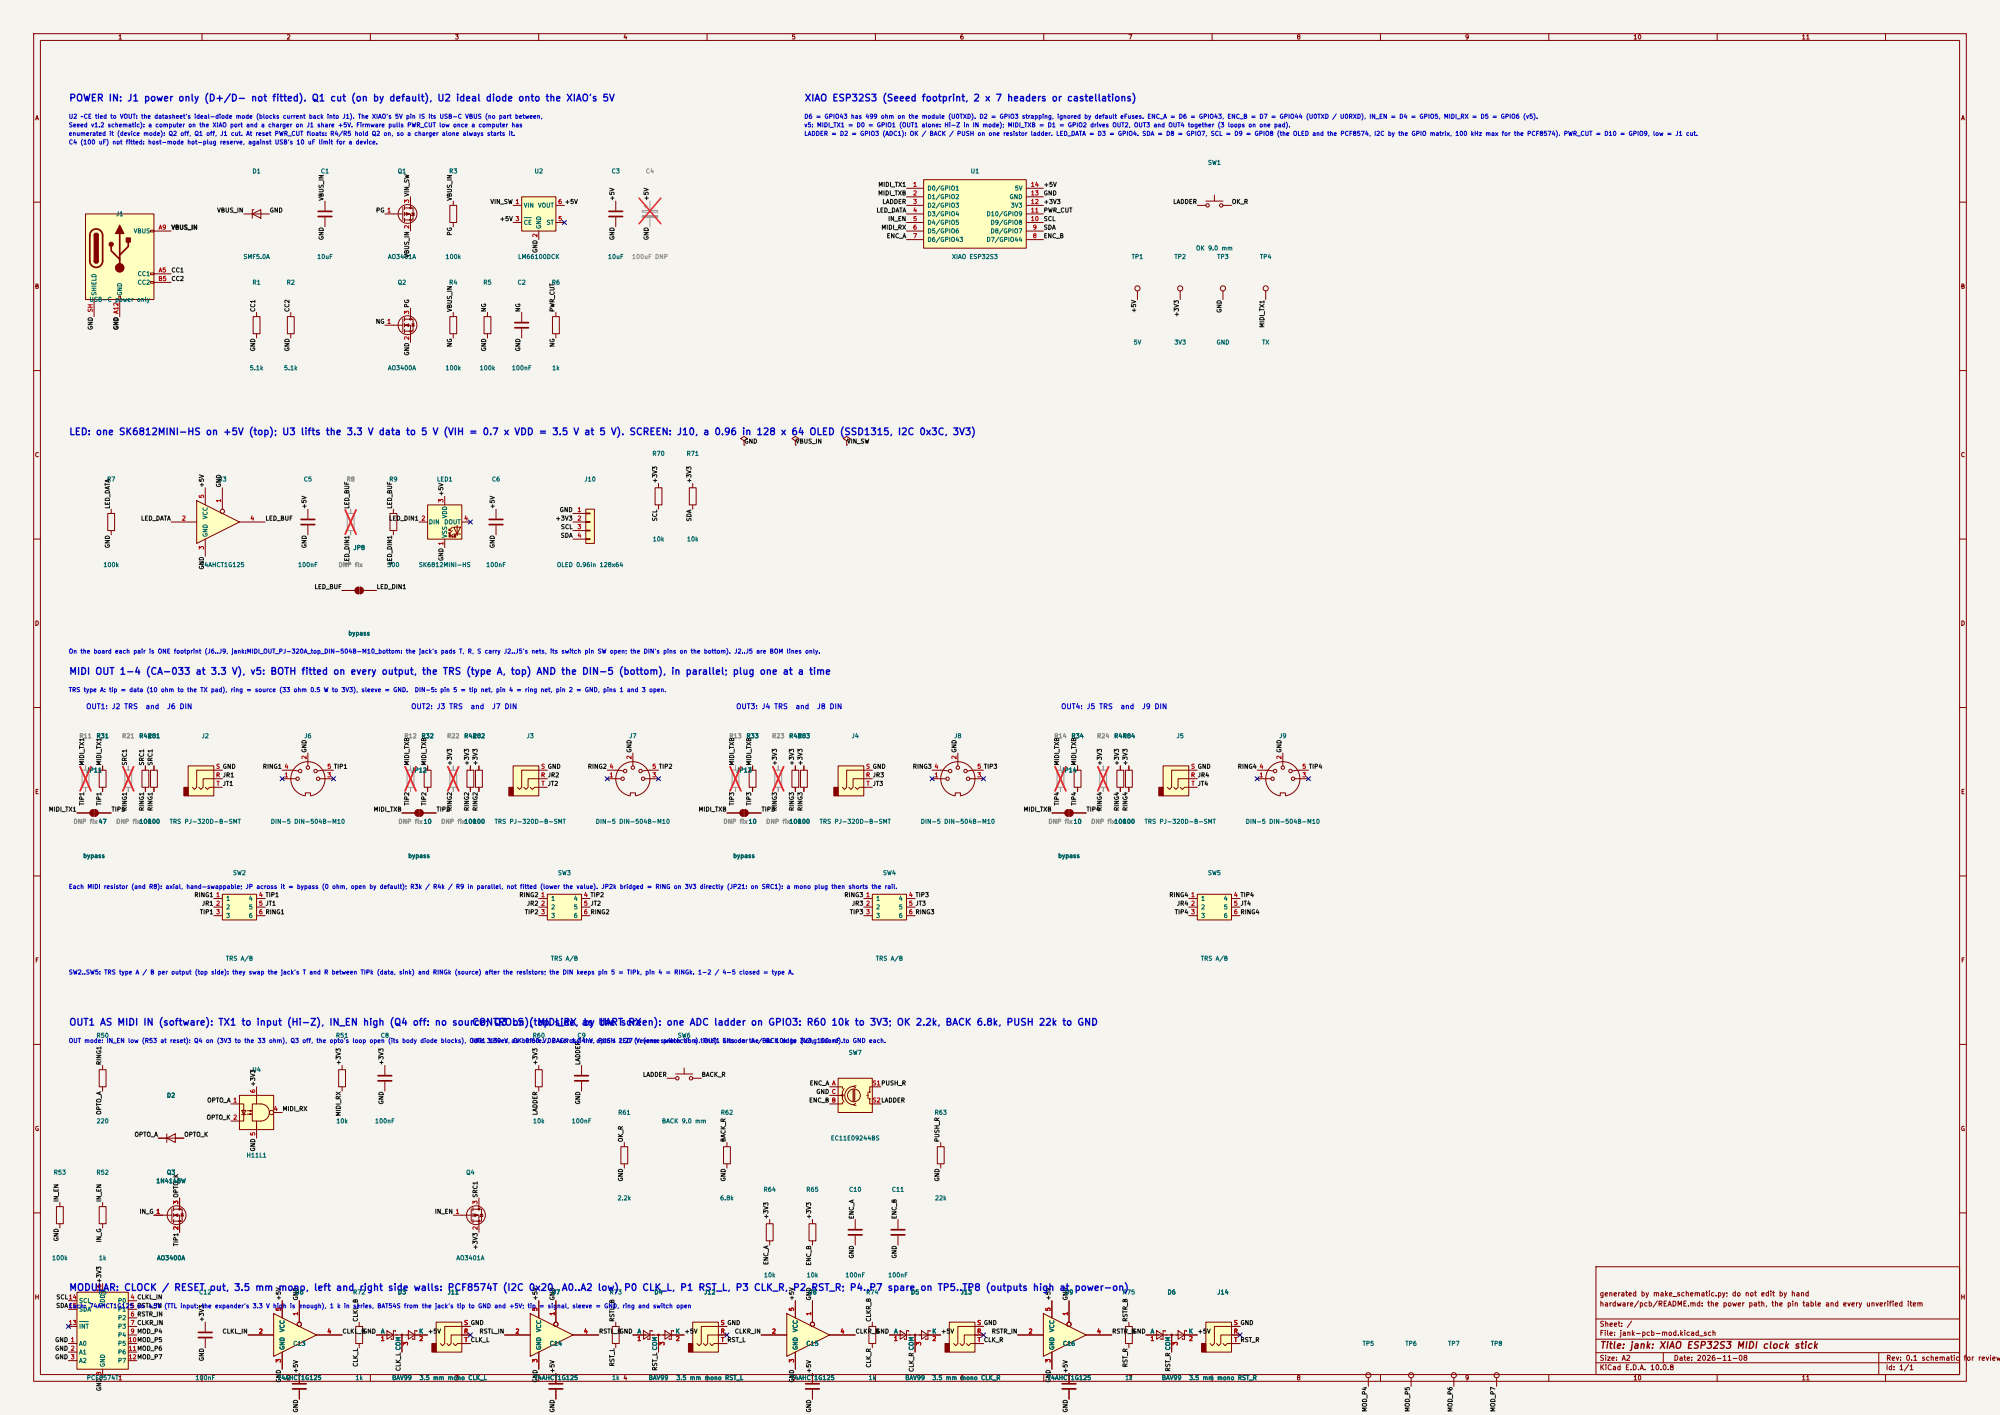
[picture p29: page 1]

POWER IN: J1 power only (D+/D- not fitted). Q1 cut (on by default), U2 ideal diode onto the XIAO's 5V

XIAO ESP32S3 (Seeed footprint, 2 x 7 headers or castellations)

C4 (100 uF) not fitted: host-mode hot-plug reserve, against USB's 10 uF limit for a device.

LED: one SK6812MINI-HS on +5V (top); U3 lifts the 3.3 V data to 5 V (VIH = 0.7 x VDD = 3.5 V at 5 V). SCREEN: J10, a 0.96 in 128 x 64 OLED (SSD1315, I2C 0x3C, 3V3)

bypass R21 DNP fix R11 DNP fixR31

On the board each pair is ONE footprint (J6..J9, jank:MIDI_OUT_PJ-320A_top_DIN-504B-M10_bottom: the jack's pads T, R, S carry J2..J5's nets, its switch pin SW open; the DIN's pins on the bottom). J2..J5 are BOM lines only. TRS type A: tip = data (10 ohm to the TX pad), ring = source (33 ohm 0.5 W to 3V3), sleeve = GND. DIN-5: pin 5 = tip net, pin 4 = ring net, pin 2 = GND, pins 1 and 3 open. OUT1 AS MIDI IN (software): TX1 to input (Hi-Z), IN_EN high (Q4 off: no source; Q3 on), MIDI_RX as UART RX

SW2..SW5: TRS type A / B per output (top side): they swap the jack's T and R between TIPk (data, sink) and RINGk (source) after the resistors; the DIN keeps pin 5 = TIPk, pin 4 = RINGk. 1-2 / 4-5 closed = type A. OUT mode: IN_EN low (R53 at reset): Q4 on (3V3 to the 33 ohm), Q3 off, the opto's loop open (its body diode blocks), OUT1 drives as before. D2 across the opto's LED (reverse protection). OUT1 sits on the BACK edge (long board). Each MIDI resistor (and R8): axial, hand-swappable; JP across it = bypass (0 ohm, open by default); R3k / R4k / R9 in parallel, not fitted (lower the value). JP2k bridged = RING on 3V3 directly (JP21: on SRC1): a mono plug then shorts the rail. MIDI OUT 1-4 (CA-033 at 3.3 V), v5: BOTH fitted on every output, the TRS (type A, top) AND the DIN-5 (bottom), in parallel; plug one at a time

Idle 3.30 V, OK 0.60 V, BACK 1.34 V, PUSH 2.27 V (one switch at a time). Encoder A / B: 10k to 3V3, 100 nF to GND each. CONTROLS (top side, by the screen): one ADC ladder on GPIO3: R60 10k to 3V3; OK 2.2k, BACK 6.8k, PUSH 22k to GND

generated by make_schematic.py; do not edit by hand
hardware/pcb/README.md: the power path, the pin table and every unverified item

Sheet: /
File: jank-pcb-mod.kicad_sch

Title: jank: XIAO ESP32S3 MIDI clock stick
