w0ts/jank/hardware/pcb/jank-pcb-schematic.pdf

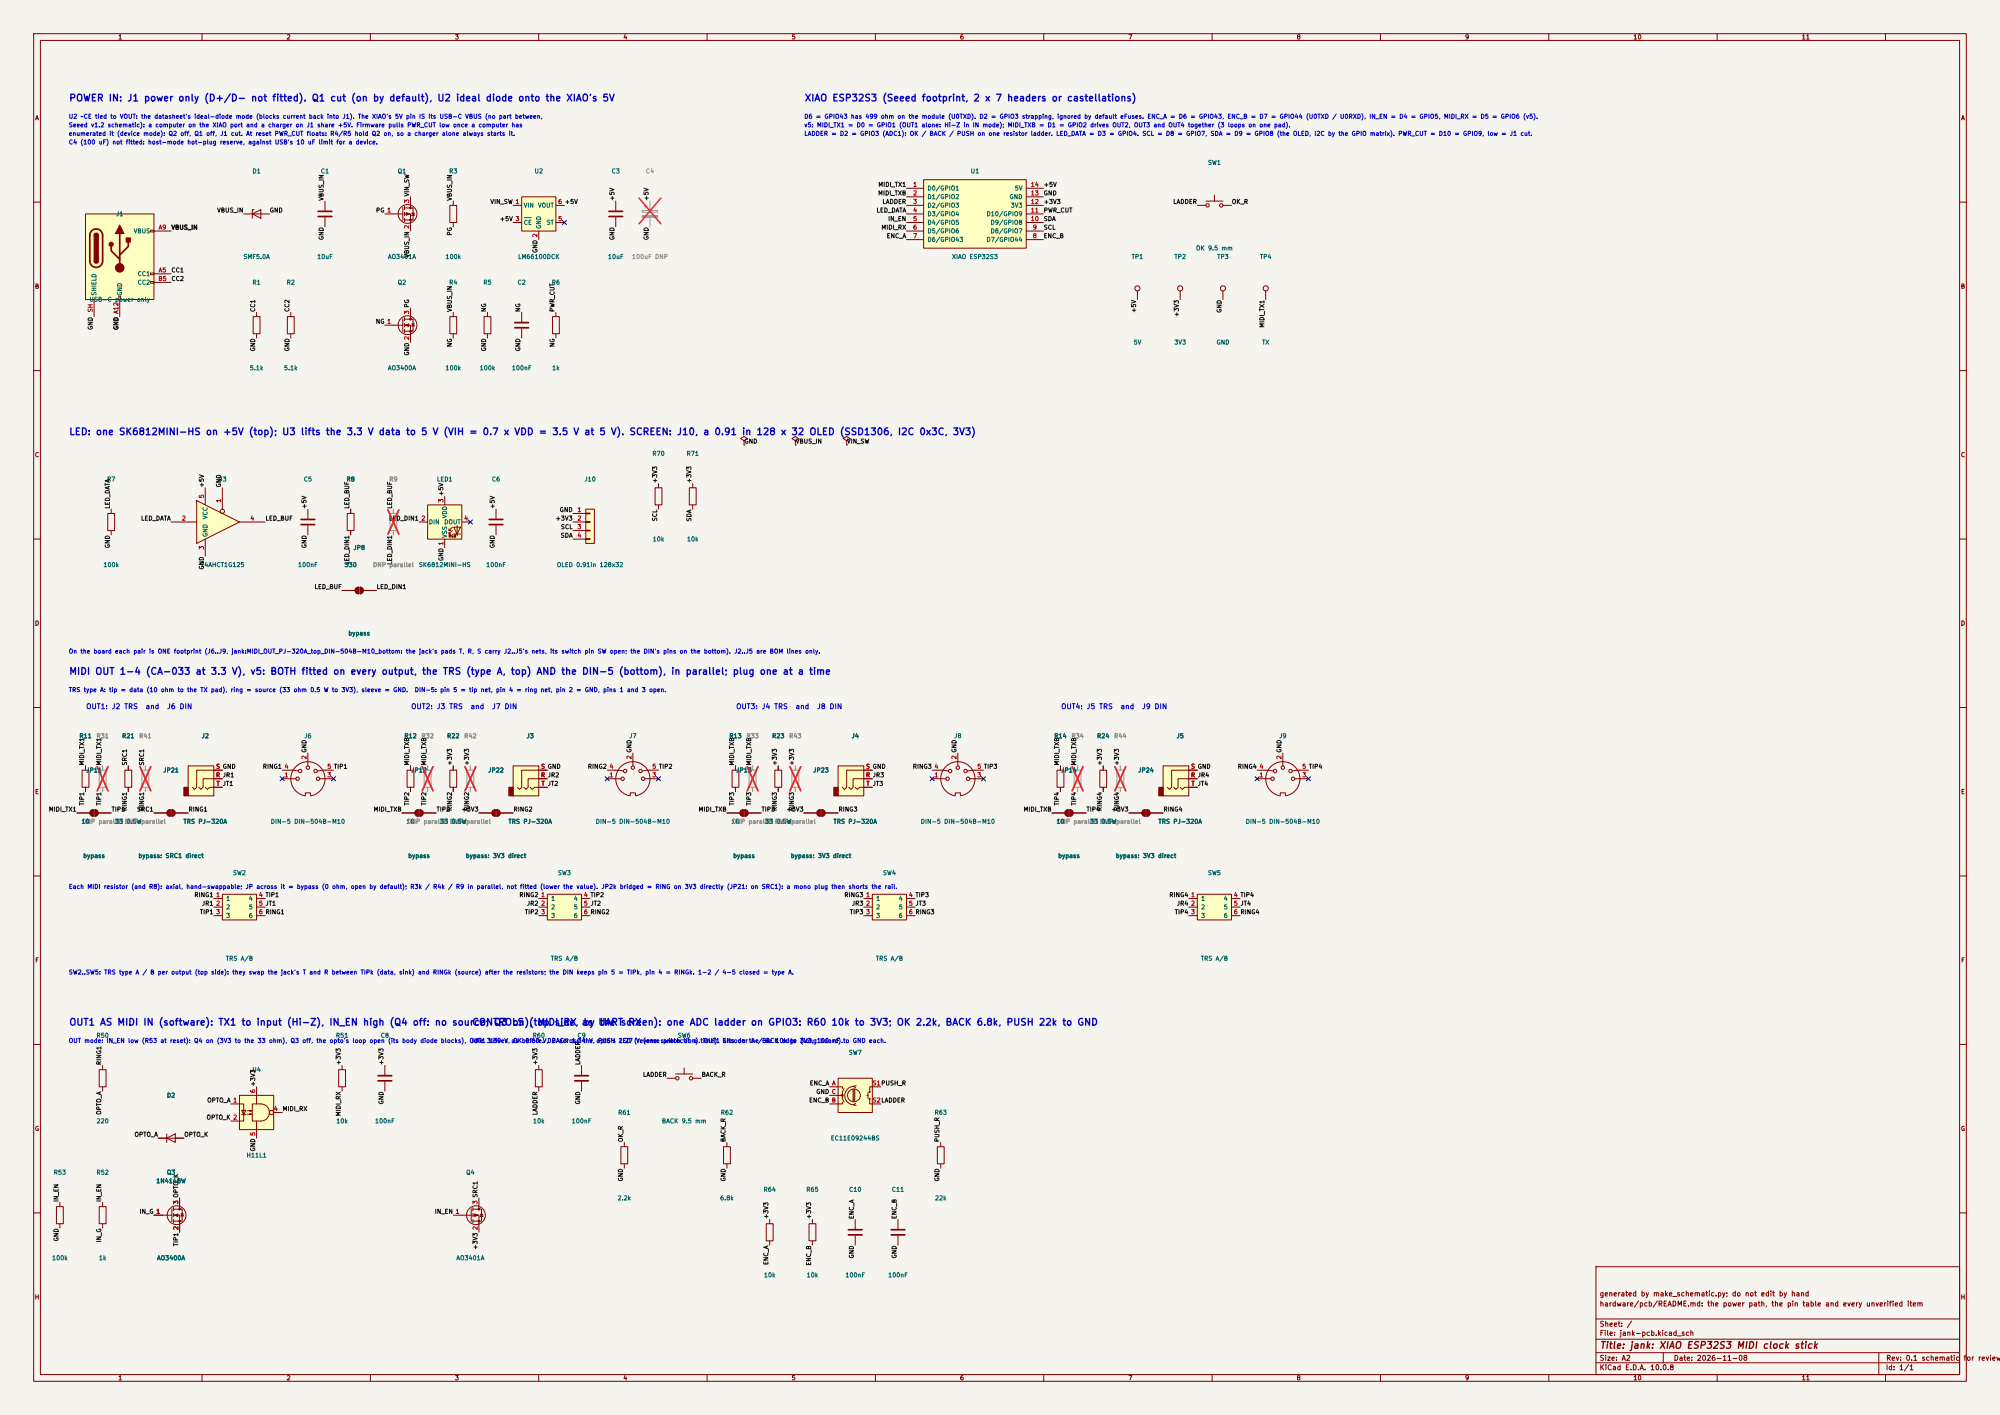
[picture p30: page 1]

U2 ~CE tied to VOUT: the datasheet's ideal-diode mode (blocks current back into J1). The XIAO's 5V pin IS its USB-C VBUS (no part between, Seeed v1.2 schematic): a computer on the XIAO port and a charger on J1 share +5V. Firmware pulls PWR_CUT low once a computer has POWER IN: J1 power only (D+/D- not fitted). Q1 cut (on by default), U2 ideal diode onto the XIAO's 5V

XIAO ESP32S3 (Seeed footprint, 2 x 7 headers or castellations)

D6 = GPIO43 has 499 ohm on the module (U0TXD). D2 = GPIO3 strapping, ignored by default eFuses. ENC_A = D6 = GPIO43, ENC_B = D7 = GPIO44 (U0TXD / U0RXD), IN_EN = D4 = GPIO5, MIDI_RX = D5 = GPIO6 (v5).
v5: MIDI_TX1 = D0 = GPIO1 (OUT1 alone: Hi-Z in IN mode); MIDI_TXB = D1 = GPIO2 drives OUT2, OUT3 and OUT4 together (3 loops on one pad).
LADDER = D2 = GPIO3 (ADC1): OK / BACK / PUSH on one resistor ladder. LED_DATA = D3 = GPIO4. SCL = D8 = GPIO7, SDA = D9 = GPIO8 (the OLED, I2C by the GPIO matrix). PWR_CUT = D10 = GPIO9, low = J1 cut.

enumerated it (device mode): Q2 off, Q1 off, J1 cut. At reset PWR_CUT floats: R4/R5 hold Q2 on, so a charger alone always starts it.
C4 (100 uF) not fitted: host-mode hot-plug reserve, against USB's 10 uF limit for a device.

LED: one SK6812MINI-HS on +5V (top); U3 lifts the 3.3 V data to 5 V (VIH = 0.7 x VDD = 3.5 V at 5 V). SCREEN: J10, a 0.91 in 128 x 32 OLED (SSD1306, I2C 0x3C, 3V3)

On the board each pair is ONE footprint (J6..J9, jank:MIDI_OUT_PJ-320A_top_DIN-504B-M10_bottom: the jack's pads T, R, S carry J2..J5's nets, its switch pin SW open; the DIN's pins on the bottom). J2..J5 are BOM lines only.
MIDI OUT 1-4 (CA-033 at 3.3 V), v5: BOTH fitted on every output, the TRS (type A, top) AND the DIN-5 (bottom), in parallel; plug one at a time

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

Sheet: /
File: jank-pcb.kicad_sch
Title: jank: XIAO ESP32S3 MIDI clock stick
