w0ts/jank/hardware/pcb/jank-pcb-mod.kicad_pcb

## KiCad design hardware/pcb/jank-pcb-mod.kicad_pcb (2026-11-09)

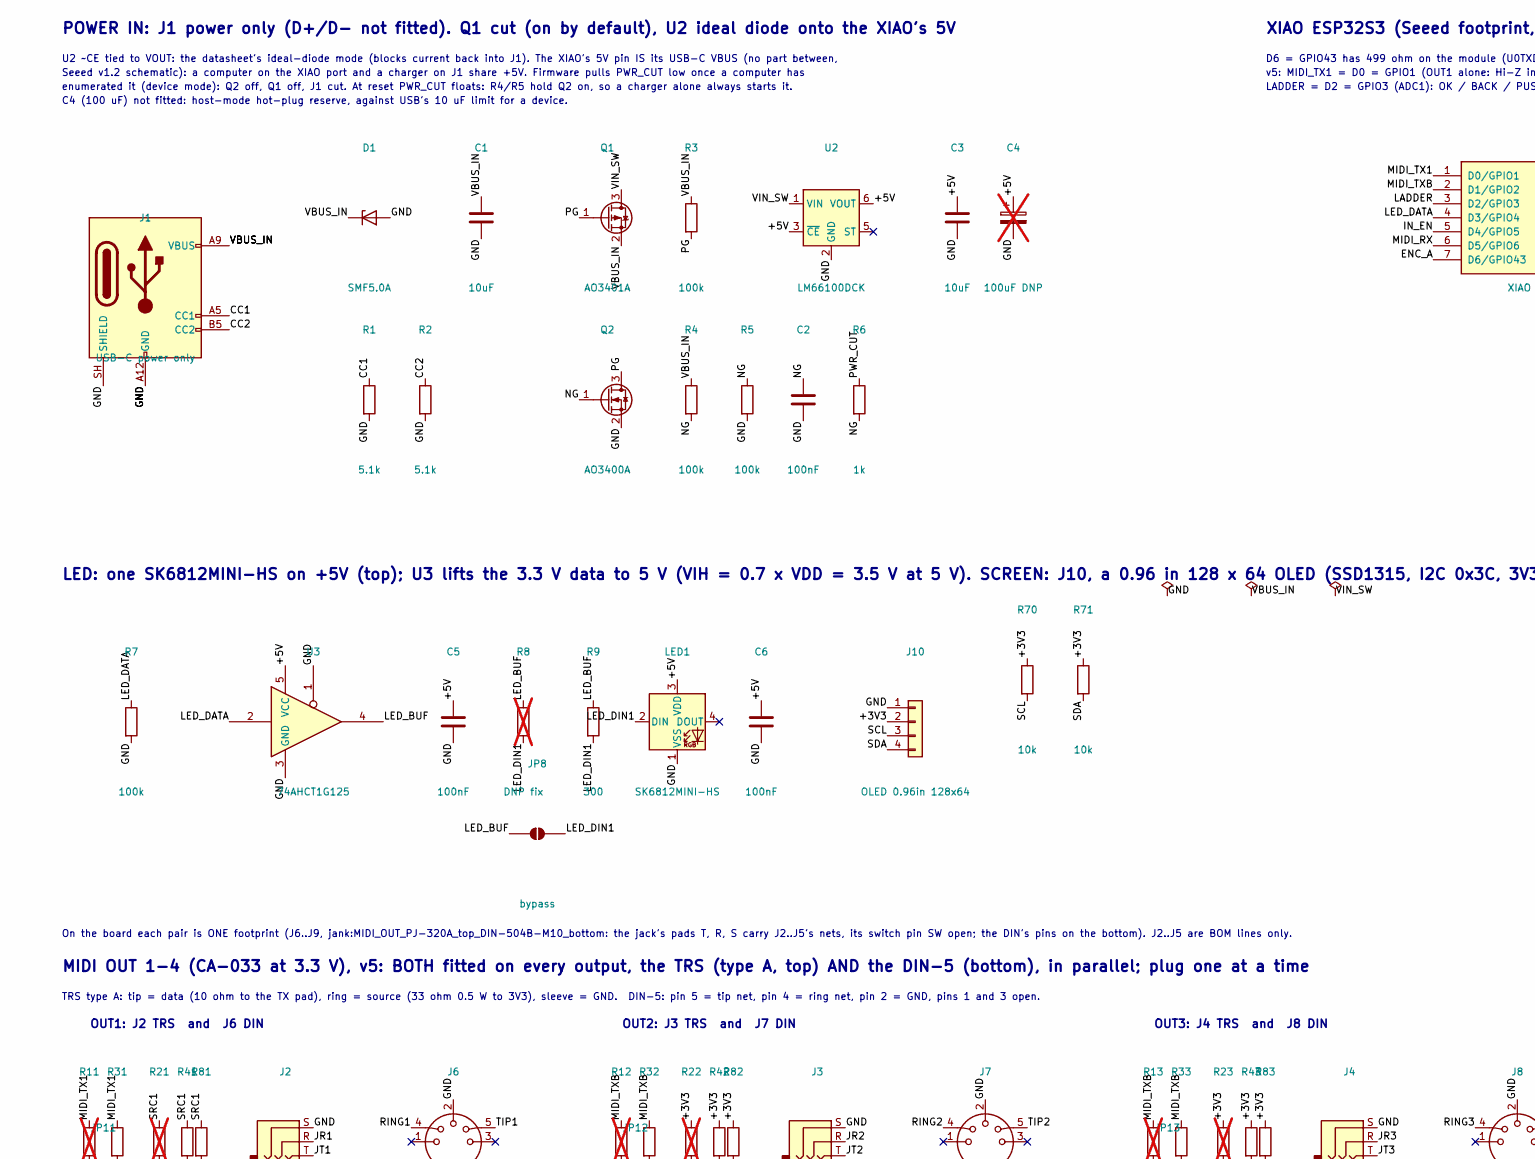
[picture p31: schematic jank-pcb-mod.kicad_sch, jank: XIAO ESP32S3 MIDI clock stick, part in row 1, column 1]

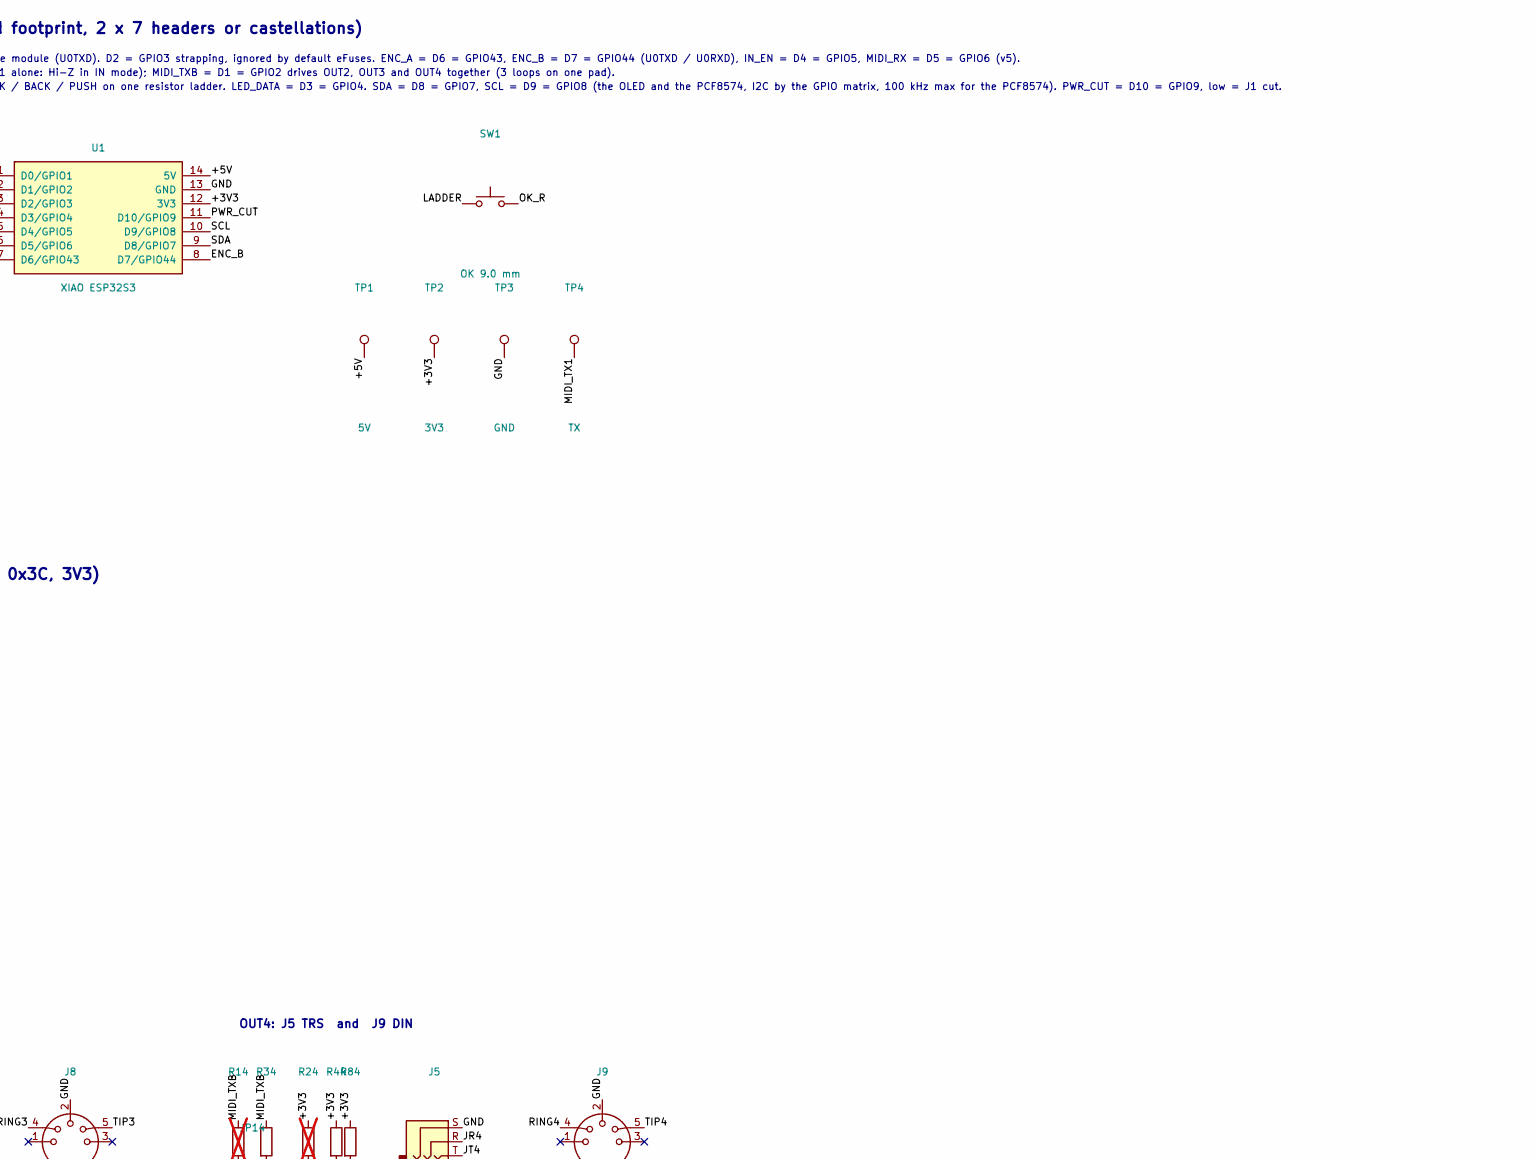
[picture p32: schematic jank-pcb-mod.kicad_sch, jank: XIAO ESP32S3 MIDI clock stick, part in row 1, column 2]

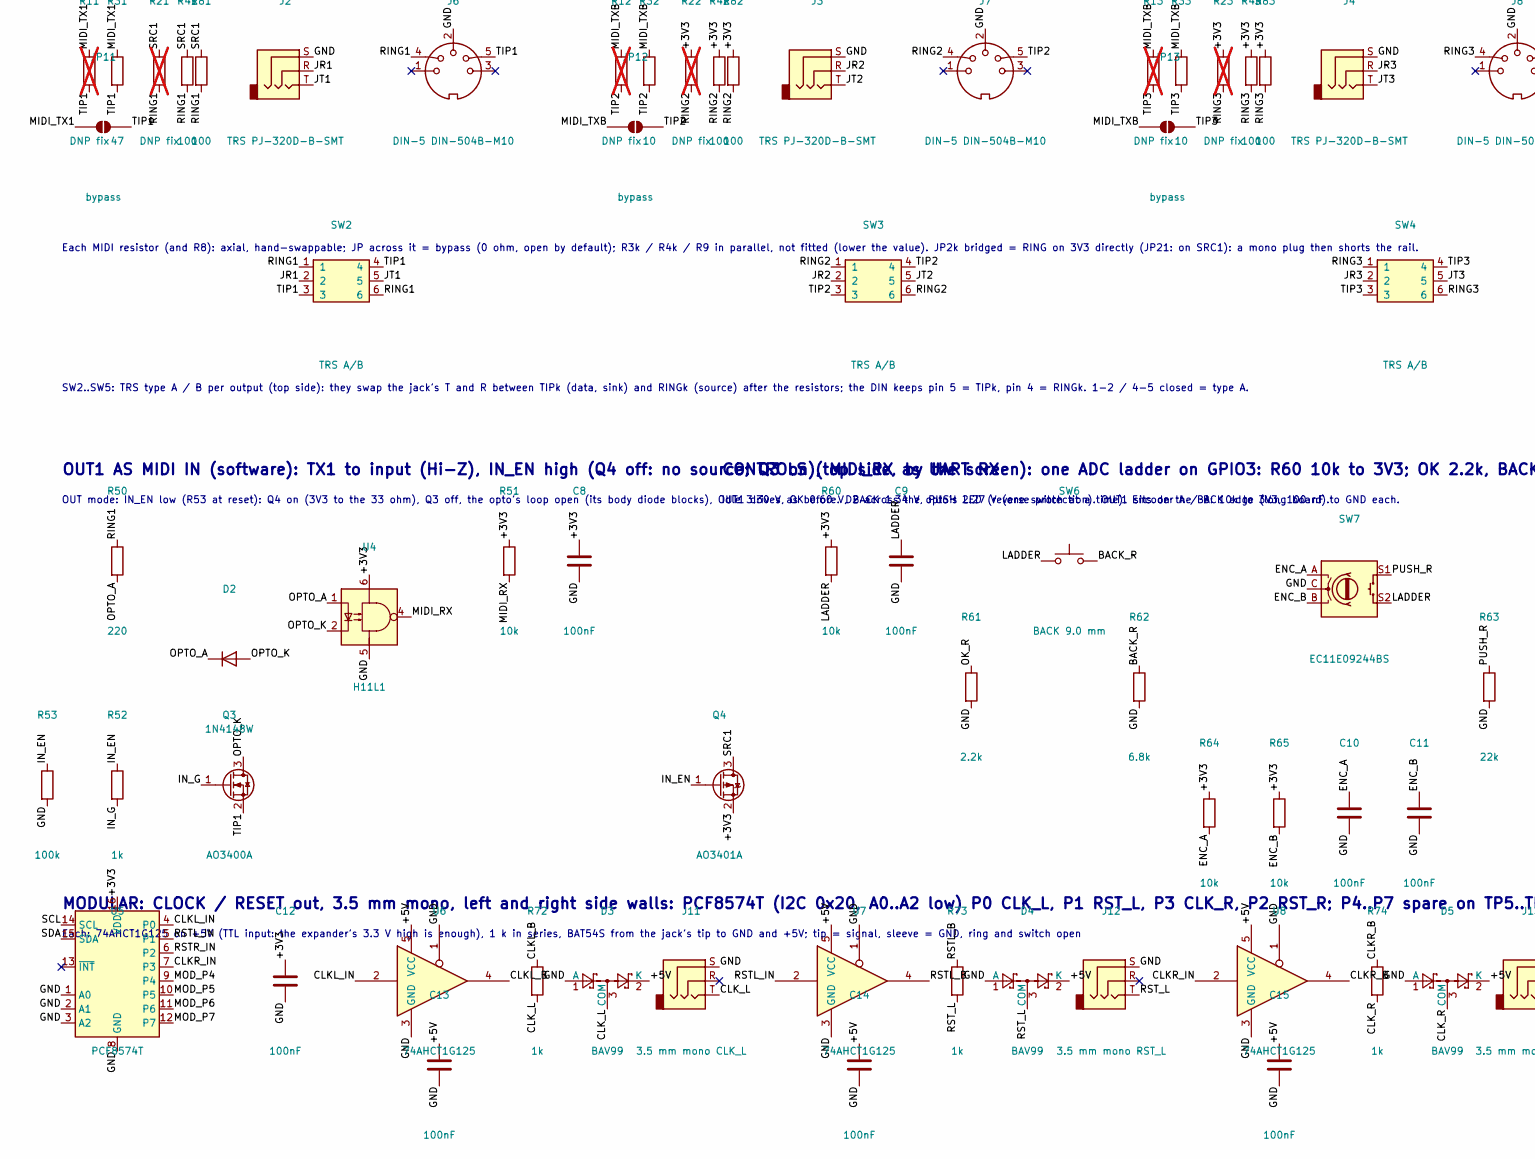
[picture p33: schematic jank-pcb-mod.kicad_sch, jank: XIAO ESP32S3 MIDI clock stick, part in row 2, column 1]

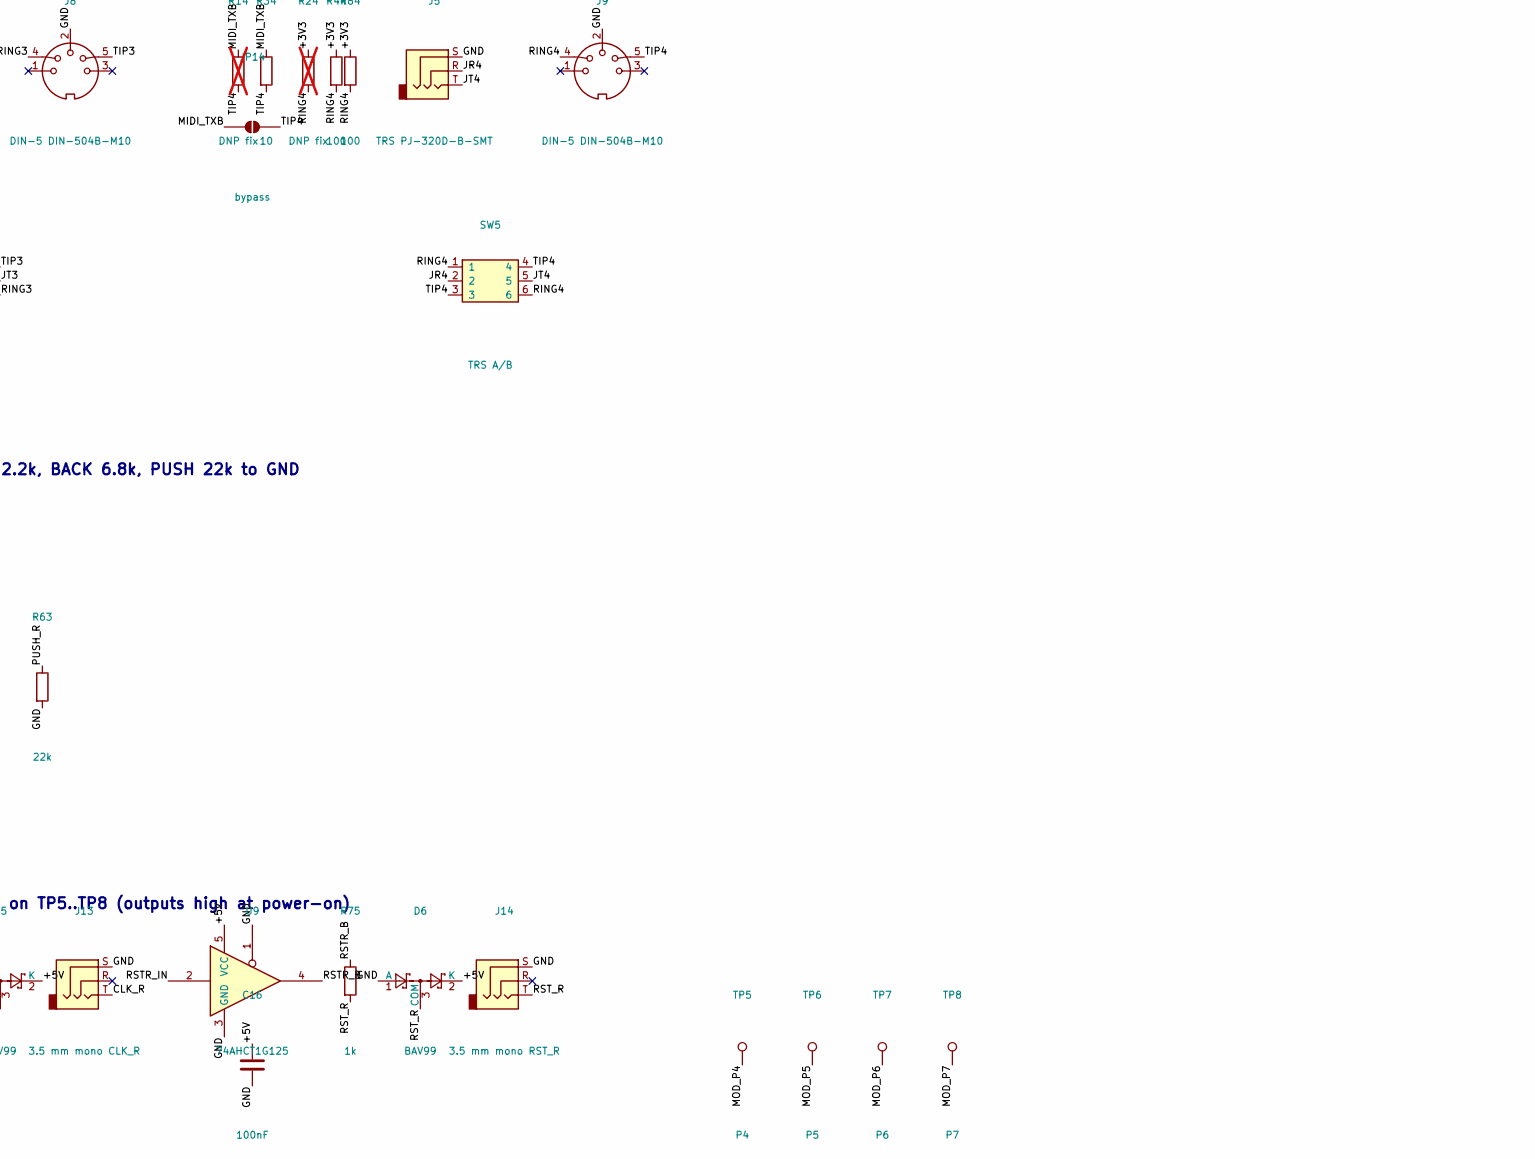
[picture p34: schematic jank-pcb-mod.kicad_sch, jank: XIAO ESP32S3 MIDI clock stick, part in row 2, column 2]

Parts:
C1, C3: 10uF; C_0805_2012Metric_Pad1.18x1.45mm_HandSolder; MPN Samsung CL21A106KAYNNNE
C2, C5, C6, C8, C9, C10, C11, C12, C13, C14, C15, C16: 100nF; C_0805_2012Metric_Pad1.18x1.45mm_HandSolder; MPN YAGEO CC0805KRX7R9BB104
C4: 100uF DNP; CP_Elec_5x5.4; MPN ROQANG RVT1C101M0505; not fitted
D1: SMF5.0A; D_SOD-123F; MPN MDD SMF5.0A
D2: 1N4148W; D_SOD-123; MPN Semtech 1N4148W
D3, D4, D5, D6: BAV99; SOT-23; MPN BAV99
J1: USB-C power only; USB_C_SHOUHAN_TYPE-C-6P; MPN SHOU HAN TYPE-C 6P
J2, J3, J4, J5: TRS PJ-320D-B-SMT; MPN XKB PJ-320D-B-SMT
J6, J7, J8, J9: DIN-5 DIN-504B-M10; MIDI_OUT_PJ-320A_top_DIN-504B-M10_bottom; MPN HOOYA DIN-504B-M10
J10: OLED 0.96in 128x64; OLED_0.96in_128x64_I2C_HS96L03W2C03; MPN HS HS96L03W2C03
J11: 3.5 mm mono CLK_L; Jack_3.5mm_XKB_PJ-320A_Horizontal; MPN XKB PJ-320A
J12: 3.5 mm mono RST_L; Jack_3.5mm_XKB_PJ-320A_Horizontal; MPN XKB PJ-320A
J13: 3.5 mm mono CLK_R; Jack_3.5mm_XKB_PJ-320A_Horizontal; MPN XKB PJ-320A
J14: 3.5 mm mono RST_R; Jack_3.5mm_XKB_PJ-320A_Horizontal; MPN XKB PJ-320A
JP8, JP11, JP12, JP13, JP14: bypass; SolderJumper-2_P1.3mm_Open_RoundedPad1.0x1.5mm
LED1: SK6812MINI-HS; LED_SK6812MINI-HS_3.7x3.5mm_HandSolder; MPN OPSCO SK6812MINI-HS
Q1, Q4: AO3401A; SOT-23; MPN AOS AO3401A
Q2, Q3: AO3400A; SOT-23; MPN AOS AO3400A
R1, R2: 5.1k; R_0805_2012Metric_Pad1.20x1.40mm_HandSolder; MPN UNI-ROYAL 0805W8F5101T5E
R3, R4, R5, R7, R53: 100k; R_0805_2012Metric_Pad1.20x1.40mm_HandSolder; MPN UNI-ROYAL 0805W8F1003T5E
R6, R52, R72, R73, R74, R75: 1k; R_0805_2012Metric_Pad1.20x1.40mm_HandSolder; MPN UNI-ROYAL 0805W8F1001T5E
R8, R11, R12, R13, R14: DNP fix; R_Axial_DIN0207_L6.3mm_D2.5mm_P2.54mm_Vertical; not fitted
R9: 300; R_1206_3216Metric_Pad1.30x1.75mm_HandSolder; MPN UNI-ROYAL 1206W4F3000T5E
R21, R22, R23, R24: DNP fix; R_Axial_DIN0309_L9.0mm_D3.2mm_P2.54mm_Vertical; not fitted
R31: 47; R_1206_3216Metric_Pad1.30x1.75mm_HandSolder; MPN UNI-ROYAL 1206W4F470JT5E
R32, R33, R34: 10; R_1206_3216Metric_Pad1.30x1.75mm_HandSolder; MPN UNI-ROYAL 1206W4F100JT5E
R41, R42, R43, R44, R81, R82, R83, R84: 100; R_1206_3216Metric_Pad1.30x1.75mm_HandSolder; MPN UNI-ROYAL 1206W4F1000T5E
R50: 220; R_0805_2012Metric_Pad1.20x1.40mm_HandSolder; MPN UNI-ROYAL 0805W8F2200T5E
R51, R60, R64, R65, R70, R71: 10k; R_0805_2012Metric_Pad1.20x1.40mm_HandSolder; MPN UNI-ROYAL 0805W8F1002T5E
R61: 2.2k; R_0805_2012Metric_Pad1.20x1.40mm_HandSolder; MPN UNI-ROYAL 0805W8F2201T5E
R62: 6.8k; R_0805_2012Metric_Pad1.20x1.40mm_HandSolder; MPN UNI-ROYAL 0805W8F6801T5E
R63: 22k; R_0805_2012Metric_Pad1.20x1.40mm_HandSolder; MPN UNI-ROYAL 0805W8F2202T5E
SW1: OK 9.0 mm; SW_PUSH_6mm; MPN HRO K2-1102DP-K4SW-04
SW2: TRS A/B; SW_Slide_DPDT_SS3235S_SMD; MPN XKB SS-3235S-L2
SW3, SW4, SW5: TRS A/B; SW_Slide_DPDT_MSS22D18; MPN SHOU HAN MSS22D18G2
SW6: BACK 9.0 mm; SW_PUSH_6mm; MPN HRO K2-1102DP-K4SW-04
SW7: EC11E09244BS; RotaryEncoder_Alps_EC11E-Switch_Vertical_H20mm; MPN ALPS EC11E09244BS
TP1: 5V; TestPoint_Pad_D1.5mm
TP2: 3V3; TestPoint_Pad_D1.5mm
TP3: GND; TestPoint_Pad_D1.5mm
TP4: TX; TestPoint_Pad_D1.5mm
TP5: P4; TestPoint_Pad_D1.0mm
TP6: P5; TestPoint_Pad_D1.0mm
TP7: P6; TestPoint_Pad_D1.0mm
TP8: P7; TestPoint_Pad_D1.0mm
U1: XIAO ESP32S3; XIAO-ESP32-S3-DIP; MPN 113991114
U2: LM66100DCK; SOT-363_SC-70-6; MPN TI LM66100DCKR
U3, U6, U7, U8, U9: 74AHCT1G125; SOT-23-5_HandSoldering; MPN TI SN74AHCT1G125DBVR
U4: H11L1; DIP-6_W7.62mm; MPN EVERLIGHT H11L1
U5: PCF8574T; SOIC-16W_7.5x10.3mm_P1.27mm; MPN NXP PCF8574T/3

Connections:
+3V3: C8.1, C12.1, J10.2, Q4.2 (S), R22.1, R23.1, R24.1, R42.1, R43.1, R44.1, R51.1, R60.1, R64.1, R65.1, R70.1, R71.1, R82.1, R83.1, R84.1, TP2.1, U1.12 (3V3), U4.6, U5.16 (VDD)
+5V: C3.1, C4.1, C5.1, C6.1, C13.1, C14.1, C15.1, C16.1, D3.2 (K), D4.2 (K), D5.2 (K), D6.2 (K), LED1.3 (VDD), TP1.1, U1.14 (5V), U2.3 (~CE), U2.6 (VOUT), U3.5 (VCC), U6.5 (VCC), U7.5 (VCC), U8.5 (VCC), U9.5 (VCC)
BACK_R: R62.1, SW6.2
CC1: J1.A5 (CC1), R1.1
CC2: J1.B5 (CC2), R2.1
CLKL_B: R72.1, U6.4
CLKL_IN: U5.4 (P0), U6.2
CLKR_B: R74.1, U8.4
CLKR_IN: U5.7 (P3), U8.2
CLK_L: D3.3 (COM), J11.T, R72.2
CLK_R: D5.3 (COM), J13.T, R74.2
ENC_A: C10.1, R64.2, SW7.A, U1.7 (D6/GPIO43)
ENC_B: C11.1, R65.2, SW7.B, U1.8 (D7/GPIO44)
GND: C1.2, C2.2, C3.2, C4.2, C5.2, C6.2, C8.2, C9.2, C10.2, C11.2, C12.2, C13.2, C14.2, C15.2, C16.2, D1.2 (A), D3.1 (A), D4.1 (A), D5.1 (A), D6.1 (A), J1.A12 (GND), J1.B12 (GND), J1.SH (SHIELD), J2.S, J3.S, J4.S, J5.S, J6.2, J6.E, J6.S, J7.2, J7.E, J7.S, J8.2, J8.E, J8.S, J9.2, J9.E, J9.S, J10.1, J11.S, J12.S, J13.S, J14.S, LED1.1 (VSS), Q2.2 (S), R1.2, R2.2, R5.2, R7.2, R53.2, R61.2, R62.2, R63.2, SW7.C, TP3.1, U1.13 (GND), U2.2 (GND), U3.1, U3.3 (GND), U4.5, U5.1 (A0), U5.2 (A1), U5.3 (A2), U5.8 (GND), U6.1, U6.3 (GND), U7.1, U7.3 (GND), U8.1, U8.3 (GND), U9.1, U9.3 (GND)
IN_EN: Q4.1 (G), R52.1, R53.1, U1.5 (D4/GPIO5)
IN_G: Q3.1 (G), R52.2
JR1: J2.R, J6.R, SW2.2
JR2: J3.R, J7.R, SW3.2
JR3: J4.R, J8.R, SW4.2
JR4: J5.R, J9.R, SW5.2
JT1: J2.T, J6.T, SW2.5
JT2: J3.T, J7.T, SW3.5
JT3: J4.T, J8.T, SW4.5
JT4: J5.T, J9.T, SW5.5
LADDER: C9.1, R60.2, SW1.1, SW6.1, SW7.S2, U1.3 (D2/GPIO3)
LED_BUF: JP8.1 (A), R8.1, R9.1, U3.4
LED_DATA: R7.1, U1.4 (D3/GPIO4), U3.2
LED_DIN1: JP8.2 (B), LED1.2 (DIN), R8.2, R9.2
MIDI_RX: R51.2, U1.6 (D5/GPIO6), U4.4
MIDI_TX1: JP11.1 (A), R11.1, R31.1, TP4.1, U1.1 (D0/GPIO1)
MIDI_TXB: JP12.1 (A), JP13.1 (A), JP14.1 (A), R12.1, R13.1, R14.1, R32.1, R33.1, R34.1, U1.2 (D1/GPIO2)
MOD_P4: TP5.1, U5.9 (P4)
MOD_P5: TP6.1, U5.10 (P5)
MOD_P6: TP7.1, U5.11 (P6)
MOD_P7: TP8.1, U5.12 (P7)
NG: C2.1, Q2.1 (G), R4.2, R5.1, R6.2
OK_R: R61.1, SW1.2
OPTO_A: D2.1 (K), R50.2, U4.1
OPTO_K: D2.2 (A), Q3.3 (D), U4.2
PG: Q1.1 (G), Q2.3 (D), R3.2
PUSH_R: R63.1, SW7.S1
PWR_CUT: R6.1, U1.11 (D10/GPIO9)
RING1: J6.4, R21.2, R41.2, R50.1, R81.2, SW2.1, SW2.6
RING2: J7.4, R22.2, R42.2, R82.2, SW3.1, SW3.6
RING3: J8.4, R23.2, R43.2, R83.2, SW4.1, SW4.6
RING4: J9.4, R24.2, R44.2, R84.2, SW5.1, SW5.6
RSTL_B: R73.1, U7.4
RSTL_IN: U5.5 (P1), U7.2
RSTR_B: R75.1, U9.4
RSTR_IN: U5.6 (P2), U9.2
RST_L: D4.3 (COM), J12.T, R73.2
RST_R: D6.3 (COM), J14.T, R75.2
SCL: J10.3, R70.2, U1.10 (D9/GPIO8), U5.14 (SCL)
SDA: J10.4, R71.2, U1.9 (D8/GPIO7), U5.15 (SDA)
SRC1: Q4.3 (D), R21.1, R41.1, R81.1
TIP1: J6.5, JP11.2 (B), Q3.2 (S), R11.2, R31.2, SW2.3, SW2.4
TIP2: J7.5, JP12.2 (B), R12.2, R32.2, SW3.3, SW3.4
TIP3: J8.5, JP13.2 (B), R13.2, R33.2, SW4.3, SW4.4
TIP4: J9.5, JP14.2 (B), R14.2, R34.2, SW5.3, SW5.4
VBUS_IN: C1.1, D1.1 (K), J1.A9 (VBUS), J1.B9 (VBUS), Q1.2 (S), R3.1, R4.1
VIN_SW: Q1.3 (D), U2.1 (VIN)

Notes on the sheet:
POWER IN: J1 power only (D+/D- not fitted). Q1 cut (on by default), U2 ideal diode onto the XIAO's 5V
U2 ~CE tied to VOUT: the datasheet's ideal-diode mode (blocks current back into J1). The XIAO's 5V pin IS its USB-C VBUS (no part between,
Seeed v1.2 schematic): a computer on the XIAO port and a charger on J1 share +5V. Firmware pulls PWR_CUT low once a computer has
enumerated it (device mode): Q2 off, Q1 off, J1 cut. At reset PWR_CUT floats: R4/R5 hold Q2 on, so a charger alone always starts it.
C4 (100 uF) not fitted: host-mode hot-plug reserve, against USB's 10 uF limit for a device.
XIAO ESP32S3 (Seeed footprint, 2 x 7 headers or castellations)
D6 = GPIO43 has 499 ohm on the module (U0TXD). D2 = GPIO3 strapping, ignored by default eFuses. ENC_A = D6 = GPIO43, ENC_B = D7 = GPIO44 (U0TXD / U0RXD), IN_EN = D4 = GPIO5, MIDI_RX = D5 = GPIO6 (v5).
v5: MIDI_TX1 = D0 = GPIO1 (OUT1 alone: Hi-Z in IN mode); MIDI_TXB = D1 = GPIO2 drives OUT2, OUT3 and OUT4 together (3 loops on one pad).
LADDER = D2 = GPIO3 (ADC1): OK / BACK / PUSH on one resistor ladder. LED_DATA = D3 = GPIO4. SDA = D8 = GPIO7, SCL = D9 = GPIO8 (the OLED and the PCF8574, I2C by the GPIO matrix, 100 kHz max for the PCF8574). PWR_CUT = D10 = GPIO9, low = J1 cut.
LED: one SK6812MINI-HS on +5V (top); U3 lifts the 3.3 V data to 5 V (VIH = 0.7 x VDD = 3.5 V at 5 V). SCREEN: J10, a 0.96 in 128 x 64 OLED (SSD1315, I2C 0x3C, 3V3)
MIDI OUT 1-4 (CA-033 at 3.3 V), v5: BOTH fitted on every output, the TRS (type A, top) AND the DIN-5 (bottom), in parallel; plug one at a time
TRS type A: tip = data (10 ohm to the TX pad), ring = source (33 ohm 0.5 W to 3V3), sleeve = GND. DIN-5: pin 5 = tip net, pin 4 = ring net, pin 2 = GND, pins 1 and 3 open.
OUT1: J2 TRS and J6 DIN
OUT2: J3 TRS and J7 DIN
OUT3: J4 TRS and J8 DIN
OUT4: J5 TRS and J9 DIN
SW2..SW5: TRS type A / B per output (top side): they swap the jack's T and R between TIPk (data, sink) and RINGk (source) after the resistors; the DIN keeps pin 5 = TIPk, pin 4 = RINGk. 1-2 / 4-5 closed = type A.
OUT1 AS MIDI IN (software): TX1 to input (Hi-Z), IN_EN high (Q4 off: no source; Q3 on), MIDI_RX as UART RX
OUT mode: IN_EN low (R53 at reset): Q4 on (3V3 to the 33 ohm), Q3 off, the opto's loop open (its body diode blocks), OUT1 drives as before. D2 across the opto's LED (reverse protection). OUT1 sits on the BACK edge (long board).
CONTROLS (top side, by the screen): one ADC ladder on GPIO3: R60 10k to 3V3; OK 2.2k, BACK 6.8k, PUSH 22k to GND
Idle 3.30 V, OK 0.60 V, BACK 1.34 V, PUSH 2.27 V (one switch at a time). Encoder A / B: 10k to 3V3, 100 nF to GND each.
Each MIDI resistor (and R8): axial, hand-swappable; JP across it = bypass (0 ohm, open by default); R3k / R4k / R9 in parallel, not fitted (lower the value). JP2k bridged = RING on 3V3 directly (JP21: on SRC1): a mono plug then shorts the rail.
On the board each pair is ONE footprint (J6..J9, jank:MIDI_OUT_PJ-320A_top_DIN-504B-M10_bottom: the jack's pads T, R, S carry J2..J5's nets, its switch pin SW open; the DIN's pins on the bottom). J2..J5 are BOM lines only.
MODULAR: CLOCK / RESET out, 3.5 mm mono, left and right side walls: PCF8574T (I2C 0x20, A0..A2 low) P0 CLK_L, P1 RST_L, P3 CLK_R, P2 RST_R; P4..P7 spare on TP5..TP8 (outputs high at power-on)
Each: 74AHCT1G125 on +5V (TTL input: the expander's 3.3 V high is enough), 1 k in series, BAT54S from the jack's tip to GND and +5V; tip = signal, sleeve = GND, ring and switch open

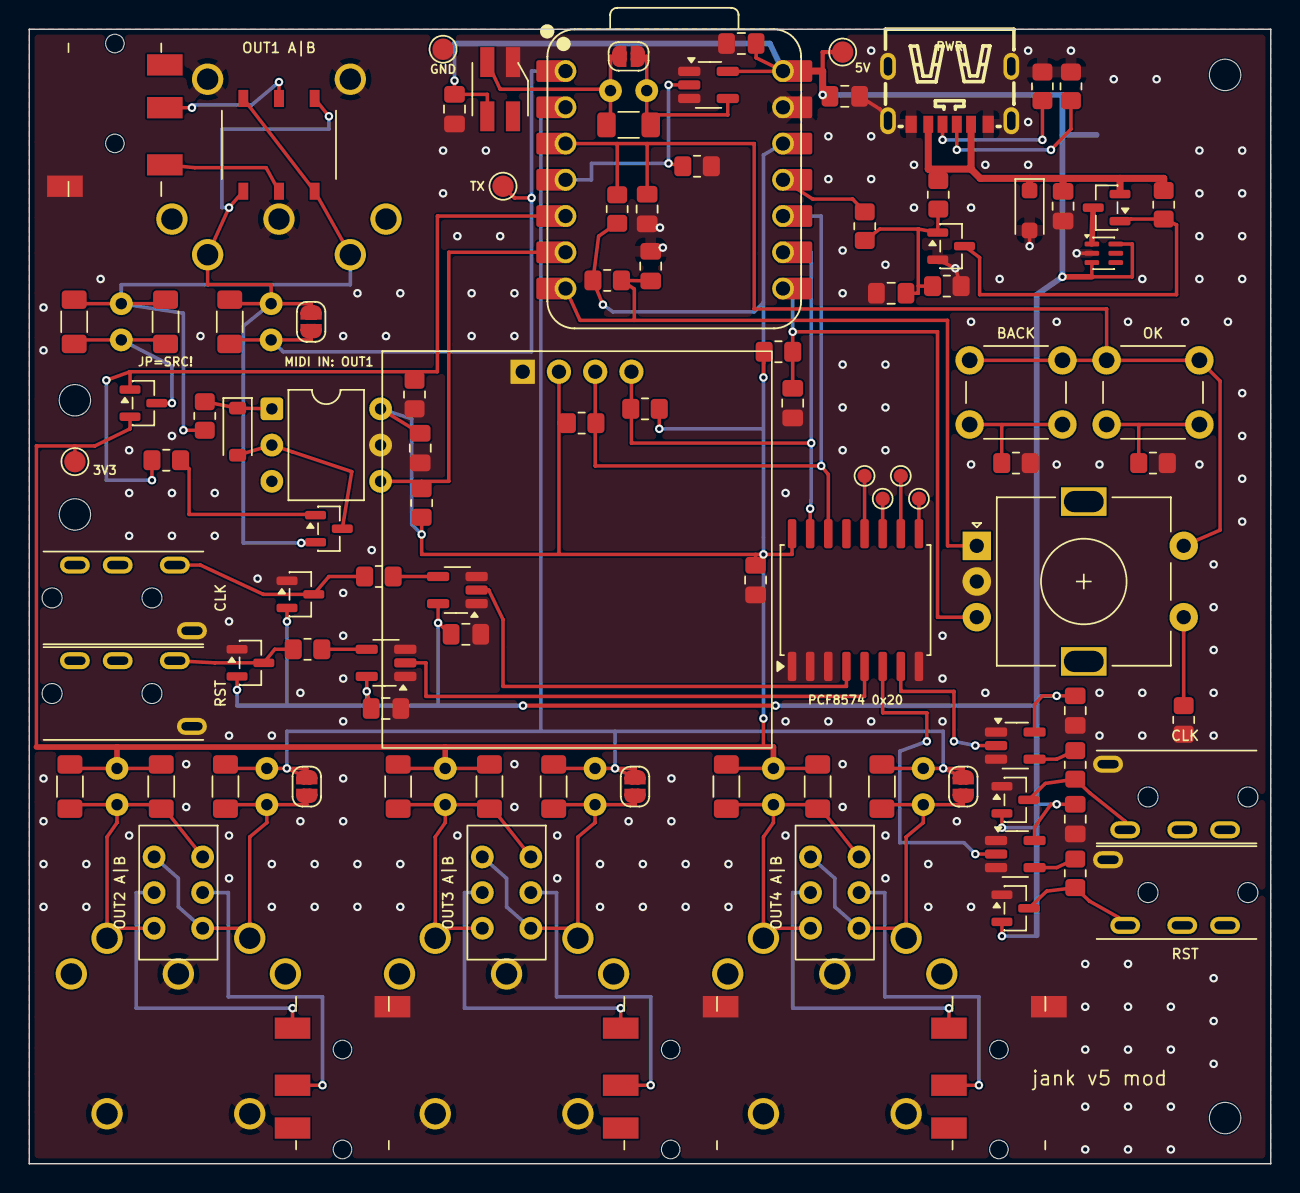
[picture p35: board jank-pcb-mod.kicad_pcb from above]

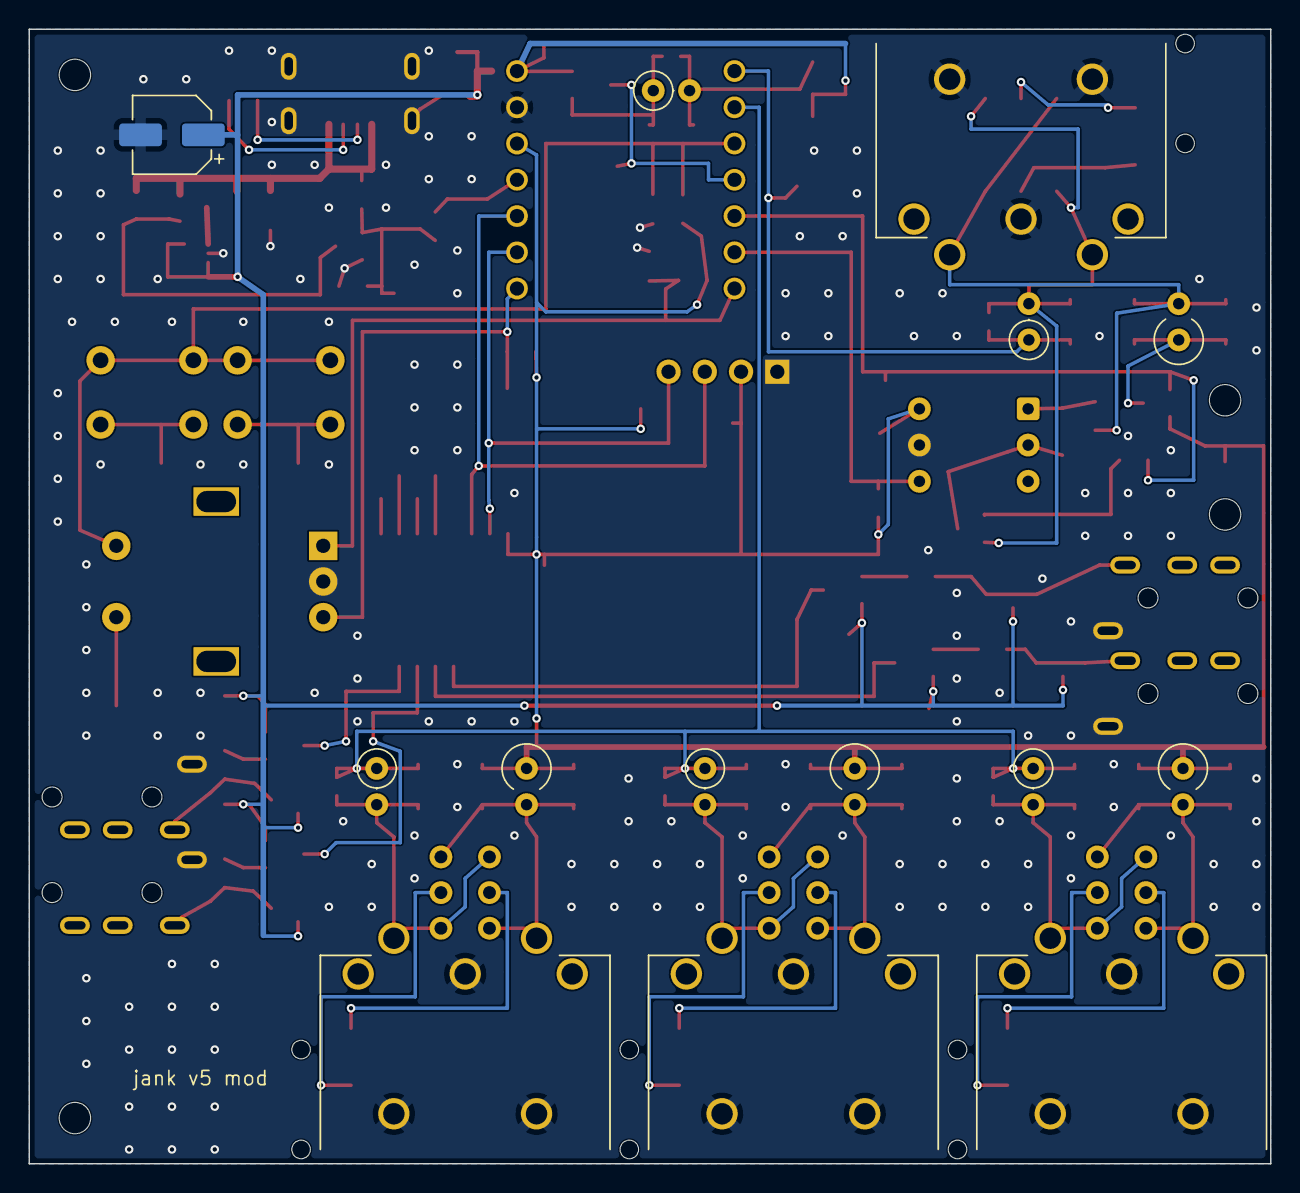
[picture p36: board jank-pcb-mod.kicad_pcb from below]

Board: 2 copper layers, 87.0 x 79.5 mm, 114 parts (10 on the bottom side), 61 nets.

Other parts of the board:
H1, H2, H3, H4: M2; MountingHole_2.2mm_M2
