w0ts/jank/firmware/main/board.h

/* SPDX-License-Identifier: GPL-3.0-only */
/* Pins by board. Choose the board in sdkconfig.<board>. BOARD_LED_RGB_GPIO >= 0: an addressable RGB LED (the PCB's
 * SK6812s), else BOARD_LED_MONO_GPIO is a plain LED, active low. BOARD_MIDI_SOURCE_GPIO >= 0: the MIDI source is a GPIO
 * driven high, else a 3V3 pin. */
#ifndef BOARD_H
#define BOARD_H
#include "sdkconfig.h"

#if CONFIG_JANK_BOARD_XIAO
/* D6 = GPIO43 for data; the board's 3V3 pad is the source. The module has 499 ohm in series on D6 (v1.2 schematic, R6):
 * MIDI current falls to about 2.3 mA (docs/boards.md); the PCB uses GPIO1, 2, 5, 4 instead. The button is BOOT, the LED the single yellow one. */
#define BOARD_BUTTON_GPIO 0
#define BOARD_BUTTON_ACTIVE_LOW 1
#define BOARD_LED_RGB_GPIO (-1)
#define BOARD_LED_MONO_GPIO 21
#define BOARD_MIDI_TX_GPIO 43
#define BOARD_MIDI_SOURCE_GPIO (-1)
#else
#error "no board chosen"
#endif
#endif
