w0ts/jank/firmware/main/app.h

/* SPDX-License-Identifier: GPL-3.0-only */
/* The firmware's modules. bridge.c owns the core's state (s_lock); radio, usb and midi know nothing of each other. */
#ifndef APP_H
#define APP_H
#include <stdbool.h>
#include <stddef.h>
#include <stdint.h>
#include "esp_err.h"
#include "sdkconfig.h"
#include "jank_clock.h"
#include "jank_core.h"
#include "jank_ui.h"

/* store.c: settings in NVS */
void store_load(struct jk_cfg *c);
esp_err_t store_save(const struct jk_cfg *c);

/* radio.c: raw 802.11 on one channel */
typedef void (*radio_rx_fn)(const uint8_t *frame, size_t len, int8_t rssi);
esp_err_t radio_start(const uint8_t mac[6], uint32_t channel, radio_rx_fn rx);
esp_err_t radio_channel(uint32_t channel);
esp_err_t radio_set_mac(const uint8_t mac[6], uint32_t channel);
esp_err_t radio_tx(const uint8_t *frame, size_t len);
/* a normal network instead of MODE JANK's air: Ethernet frames both ways */
typedef void (*radio_eth_fn)(const uint8_t *eth, size_t len);
esp_err_t radio_start_network(const uint8_t mac[6], const char *ssid, const char *pass, radio_eth_fn rx);
esp_err_t radio_network_tx(const uint8_t *eth, size_t len);
esp_err_t radio_network_set_mac(const uint8_t mac[6]);
int radio_network_up(void);
void radio_network_info(int8_t *rssi, uint8_t *channel);

/* usb.c: CDC-NCM + USB MIDI, whose SysEx carries the control line */
typedef void (*usb_frame_fn)(const uint8_t *eth, size_t len);
typedef void (*usb_free_fn)(void *token);
typedef void (*usb_line_fn)(const uint8_t *data, size_t n);
esp_err_t usb_start(const uint8_t mac[6], usb_frame_fn rx, usb_free_fn tx_done, usb_line_fn serial_rx);
int usb_up(void);
esp_err_t usb_send(const uint8_t *eth, size_t len, void *token);   /* tx_done(token) follows when ESP_OK */
/* usb_midi_host.c: the clock to USB-MIDI devices, when the port started as host */
esp_err_t usb_midi_host_start(void);
void usb_midi_host_send(const uint8_t *packets, size_t n);
bool usb_midi_isr(const uint8_t *bytes, size_t n);                  /* from the timer interrupt -> a task was woken */
void usb_serial_write(const char *text, size_t n);                 /* the control line, as SysEx on the MIDI port */

/* midi.c: the free-running microsecond timer and the 24 PPQN output */
esp_err_t midi_start(void);
int64_t midi_now_us(void);
void midi_set_quantum(uint32_t quantum);
void midi_publish(const struct jc_map *m);
void midi_want(int play);
void midi_resync(void);
void midi_stats(uint32_t *ticks, uint32_t *resyncs);

/* bridge.c */
esp_err_t bridge_start(const struct jk_cfg *cfg, const uint8_t mac[6], const uint8_t peer_mac[6]);
void bridge_apply(const struct jk_cfg *cfg);                 /* a setting changed */
void bridge_snapshot(struct jk_snapshot *s);
void bridge_away(int away);                                  /* the radio is on another channel: nothing to send */
void bridge_note_scan_groups(struct js_scan *out);
void bridge_table_start(void);                               /* frames of every group go in a table from here .. */
void bridge_table_stop(struct js_table *out);                /* .. to here */
uint32_t bridge_peers_heard(void);
int bridge_beat(int64_t *beat_ub, int32_t *mpb);
int bridge_tempo(int32_t mpb);
void bridge_diag(char *out, size_t cap);                     /* the Link clock filter, for `diag` */
void app_diag(char *out, size_t cap);                        /* restarts and the last reset's reason, for `diag` */                       /* 0 set; -1 no session to set it in */
int bridge_play(int play);                           /* 0 started / stopped; -1 no session */    /* 1 in a session, with its beat now */
uint32_t bridge_ms(void);

/* ui.c: button, LED, group scan */
esp_err_t ui_start(void);
esp_err_t ui_scan_table(struct js_table *out);               /* blocks about 1.05 s; joins nothing */

/* ctl.c: the control protocol on the serial */
esp_err_t ctl_start(void);
void ctl_serial_rx(const uint8_t *data, size_t n);
uint32_t ctl_beats(void);                                    /* counts up while the task runs */

/* ota.c: firmware updates over the control line, and the rollback's confirmation */
bool ota_busy(void);                                         /* a transfer over MIDI is running */
bool ota_line(const char *line);                             /* an "ota ..." line: handled and answered -> true */
void ota_idle(void);                                         /* called about once a second: drops a silent transfer */
void ota_validate_start(void);                               /* a new image confirms itself once USB and the control task work */
void ota_mark_valid(void);

/* drive.c: the JANK drive: wiped at every start, jank.html on it, a jank.bin copied onto it and ejected is installed */
esp_err_t drive_start(void);
#ifdef JANK_CLOCK_PROBE
esp_err_t probe_start(void);                                 /* clkprobe.c: a test build's pin probe */
void probe_mark(int64_t due, int64_t isr_now);
size_t probe_report(char *out, size_t cap, int reset);
#endif
void drive_note(const char *slot, const char *text);         /* UPDATE.TXT at the next start, if slot runs (else: rolled back) */
void drive_note_forget(void);
void drive_state(char *out, size_t cap);                     /* `drive`: ok, or the start step that failed */                                /* the image is confirmed: the note is said */

/* download.c: the ROM's download mode, with USB */
void usb_to_rom_download(void);                              /* does not return */

/* main.c: the settings' one owner */
void app_cfg_get(struct jk_cfg *c);
void app_cfg_set(const struct jk_cfg *c);
#endif
