w0ts/jank/(commit log)

2026-11-07 feat(jank): jank, an ESP32 that joins MODE JAM: a computer network adapter and MIDI clock (ESP32-S3), radio and control page on a vanilla ESP32
    A folder of Optimist for now: firmware GPL-3.0-only (it uses link.c), page MIT. Run on the Lolin32: scan, group join, Link peer seen on its page. Not run: the ESP32-S3 USB side, the FM-1 accepting its frames (LINK PEERS unconfirmed).
    [app.h, board.h, bridge.c, ctl.c, jank_clock.c, jank_clock.h]
2026-11-07 feat: jank in its own repo: USB networking, MIDI and drive on the S3, host mode, normal Wi-Fi, beat LED; the Link peer in third_party/link
    [partitions_usb.csv]
2026-11-08 feat(hardware): the jank PCB and its braced box; the UART TX signal on several pads
    hardware/pcb: KiCad project generated by scripts (make_schematic.py, make_footprints.py, make_board.py, make_mockup.py, make_fab.sh, check_nets.py) for a Seeed XIAO ESP32-S3 on headers: four MIDI outputs, each one footprint holding a CUI SDS-50J DIN and a nested right-angle CUI SJ1-3523N TRS (one populated per channel), a DPDT A/B switch per channel, OUT1 on the back edge convertible to MIDI IN in software (H11L1 opto gated by IN_EN, its source through a P-MOSFET), a power-only USB-C through an LM66100 ideal diode with a firmware cut (PWR_CUT), two SK6812-MINI-E LEDs and the MODE button under the XIAO on the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
    [jank-pcb.kicad_pcb, jank-pcb.kicad_sch, jank_box.scad, jank_box_DDDD_box.stl, jank_box_DDDD_lid.stl, jank_box_DDTT_box.stl, jank_box_DDTT_lid.stl, jank_box_DTTT_box.stl]
2026-11-08 docs: a current, short README; docs/ for the details; dead files and duplicates removed
    README.md rewritten from scratch (132 lines): what jank is (the mode is jank; MODE JAM on older FM-1 firmware), the PCB and box, the two supported S3 boards, build and flash, the button and LED as ui.c does them today, the control page and line protocol, tests, on-air facts, licensing, what is proved, next. The dongle shopping table, the jank mini and the Lolin32 sections are gone.
    New docs/: air.md (frame format, bridge, MAC, filter, Link peer, scan, normal Wi-Fi), usb.md (USB functions, host mode, XIAO VBUS), midi.md (clock, resync, timing estimates, CA-033 wiring), boards.md (AtomS3U and XIAO pins, th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
    [app.h, board.h, bridge.c, ctl.c, jank_core.h, main.c, make_mockup.py]
2026-11-08 chore: the XIAO ESP32-S3 is the only board; the AtomS3U entry removed
    The user's ruling (2026-11-08): jank is the Seeed XIAO ESP32-S3, bare for tests and on the PCB. The M5Stack AtomS3U board block, its Kconfig choice, its sdkconfig and its build target go; the RGB LED path in ui.c stays for the PCB's SK6812s. Builds (xiao, 833,168 B, 0 warnings) and host tests unchanged.
2026-11-08 feat(box): openings closed by the lid, DIN faces flush, markings
    Every wall opening is a U open to the top; the lid's tongues and keys close them, so the board goes straight in. DIN plates sit 1.3 mm in behind a 1.2 mm lip that overlaps their edges by 1.0 mm (pull-out), the cradle behind (push-in). The XIAO's socket sits in the 2.0 mm back wall's U. Debossed labels (Liberation Sans Bold, 4.0 mm capitals, 0.4 mm deep) on the lid, its tongues and the walls; check_text added. All four sets: 44 checks as required, 9 STLs one body, 0 open edges.
    [jank_box.scad, jank_box_DDDD_box.stl, jank_box_DDDD_lid.stl, jank_box_DDTT_box.stl, jank_box_DDTT_lid.stl, jank_box_DTTT_box.stl, jank_box_DTTT_lid.stl, jank_box_TTTT_box.stl]
2026-11-08 fix(box): the DIN bore is round and split between the wall and the lid, like the jacks
    The DIN plate sits behind the full 2.5 mm wall again (pull-out on the wall round the bore and on the tongue, push-in on the cradle); the 16.0 mm plug bore's lower half is in the wall, its upper half a U closed by the lid's tongue with a half-round end. The back wall is 2.5 mm and flat; the XIAO's socket sits in its U. New check_board_drop lowers the board into the box. Set DDDT (the user's) added and shown first. Five sets: 60 checks as required, 11 STLs one body, 0 open edges.
    [jank_box.scad, jank_box_DDDD_box.stl, jank_box_DDDD_lid.stl, jank_box_DDDT_box.stl, jank_box_DDDT_lid.stl, jank_box_DDTT_box.stl, jank_box_DDTT_lid.stl, jank_box_DTTT_box.stl]
2026-11-08 refactor: MODE JAM is MODE JANK here too; the cross-check follows fm1-base's wifi_jank.c and jn_ names
    The user's ruling (2026-11-08). JK_NET_JAM -> JK_NET_JANK, the control line's value 'jam' -> 'jank' (set net jank; the page follows), texts and comments; tests/run.sh and tests/crosscheck_optimist.c compile fm1-base's wifi_jank.c with its jn_ prefix. The on-air name fm1-jam-N and the BSSID are unchanged, as on the FM-1. Host tests pass against fm1-base topic/jank-term-integ; the XIAO build is unchanged in size.
    [app.h, bridge.c, jank_core.c, jank_core.h, jank_ctl.c, jank_peer.c, jank_peer.h]
2026-11-08 fix(box): A/B slots only on jack channels; the PCB's A/B switch populated only there
    The A/B switch only swaps a jack's tip and ring; a DIN channel leaves it unfitted (the user's ruling). The lid gets a slot and its A / B letters only on TRS channels (DDDT: SW5, OUT4); the check model fits switches only there. The PCB README says so; BOM.md (from make_schematic.py, BOM part only, regenerated by its bom_md()) counts the switch per TRS channel and adds the DDDT total. Five sets: 60 checks as required, 11 STLs one body, 0 open edges.
    [jank_box.scad, jank_box_DDDD_lid.stl, jank_box_DDDT_lid.stl, jank_box_DDTT_lid.stl, jank_box_DTTT_lid.stl]
2026-11-08 fix(pcb): outputs 2, 3, 4 read left to right from the front
    [jank-pcb.kicad_pcb, mockup-din.stl, mockup-trs.stl]
2026-11-08 fix(box): follow the renumbered outputs; LED labels dropped from the lid
    OUT2 and OUT4 swap places on the front (2, 3, 4 left to right from the front; OUT1 behind OUT4), and so do SW3 / SW5's slots; the LEDs carry no lid label (the sides carry the plug labels). Five sets: 60 checks as required, 11 STLs one body, 0 open edges.
    [jank_box.scad, jank_box_DDDD_box.stl, jank_box_DDDD_lid.stl, jank_box_DDDT_box.stl, jank_box_DDDT_lid.stl, jank_box_DDTT_box.stl, jank_box_DDTT_lid.stl, jank_box_DTTT_box.stl]
2026-11-08 feat(pcb): cheaper connectors: HOOYA DIN-504B-M10 and XKB PJ-320A take the DIN and jack footprints
    [jank-pcb.kicad_pcb, jank-pcb.kicad_sch, mockup-din.stl, mockup-trs.stl]
2026-11-08 fix(box): the HOOYA DIN and the XKB jack: axis 9.7, pitch 21.1, Ø5 bushing
    Connector numbers from the HOOYA DIN-504B-M10 and XKB PJ-320A drawings: DIN plate 20.9 x 19.6 x 1.8, body to 13.6, axis 9.7 (parameter), bore 16.0; jack body 6.2 x 12.2 x 5.0, bushing 5.0 / 2.0 out, U-slot 5.2, key 4.9. Walls 1.8 so the 2.0 mm bushing stands 0.1 proud; DIN push-in on the lip behind the body; front axes 52.65 / 31.55 / 10.45 and A/B slots follow. Five sets: 60 checks as required, 11 STLs one body, 0 open edges.
    [jank_box.scad, jank_box_DDDD_box.stl, jank_box_DDDD_lid.stl, jank_box_DDDT_box.stl, jank_box_DDDT_lid.stl, jank_box_DDTT_box.stl, jank_box_DDTT_lid.stl, jank_box_DTTT_box.stl]
2026-11-08 feat(pcb): v5: jacks on top, DINs below, both fitted; OLED, one LED, controls on the component side
    [jank-pcb.kicad_pcb, jank-pcb.kicad_sch, mockup-din.stl, mockup-trs.stl, mockup.stl]
2026-11-08 feat(box): v5: two-row walls, the board 20 mm up on the DINs, OLED window
    One build: every output has its jack above the board (U-slot + lid key, the lid's cap takes the push-in) and its DIN below (a closed 16.0 bore through the wall and a 1.0 mm DIN pad that bears the plate and carries the board's edge; a lip behind the body). Walls 1.8 with a flat outside. Lid 7.2 above the board (the XIAO), OLED window and far-end rib, BACK / OK / encoder / LED / four A/B slots, the XIAO's notch, J1's tongue; four M2 x 20 into webbed columns. Imports ../pcb/mockup.stl. All 12 checks as required, 3 STLs one body, 0 open edges.
    [jank_box.scad, jank_box_DDDD_box.stl, jank_box_DDDD_lid.stl, jank_box_DDDT_box.stl, jank_box_DDDT_lid.stl, jank_box_DDTT_box.stl, jank_box_DDTT_lid.stl, jank_box_DTTT_box.stl]
2026-11-08 feat(link): fm1-base's Link peer d63efc8: the measuring partner is the member heard last
    A founder at the edge of range (an ALIVE lands now and then, its pongs do not) no longer stalls a join or leaves a clock unrefreshed; a failed measurement moves on to the next member before the session is forgotten. Nothing changes on the wire. docs/air.md says so, and that the stick's scan (0.7 s without frames) at worst moves the FM-1s to measure with each other. Host tests and the crosscheck against fm1-base pass.
2026-11-08 feat(box): printed caps for OK/BACK, A/B slider caps and an encoder knob
    Button caps: 5.4 stem 3.0 above the lid through 6.0 holes, an 8.0 flange 0.3 under the lid, a 3.45 bore on the 3.4 plunger. Slider caps: 3.15 x 3.65 blocks, 1.0 above the lid, a 1.55 x 2.05 pocket on the handle; slots 3.5 x 6.0. Knob: 14 x 12, D bore 6.1 / 4.6, a pointer groove. check_caps and brace_caps added; 14 checks as required, 6 STLs one body, 0 open edges.
    [jank_box.scad, jank_box_button_cap.stl, jank_box_knob.stl, jank_box_lid.stl, jank_box_slider_cap.stl]
2026-11-08 feat(pcb): JLCPCB assembly files: BOM and placement for everything but the jacks, DINs and the XIAO
    [bom.csv, jank-pcb.kicad_pcb, jank-pcb.kicad_sch, mockup.stl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]
2026-11-08 feat(pcb): v5 single-side assembly: the bottom 0805s moved to the top; assembly files top-only
    [bom.csv, jank-pcb.kicad_pcb, jank-pcb.kicad_sch, mockup.stl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]
2026-11-08 feat(pcb): modular variant: clock and reset 3.5 mm outputs on both sides via an I2C expander and 5 V buffers
    [bom.csv, jank-pcb-mod.kicad_pcb, jank-pcb-mod.kicad_sch, jank-pcb.kicad_pcb, mockup-mod.stl, mockup.stl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]
2026-11-08 feat(box): the modular board: 79.5 mm deep, clock and reset jacks on the side walls
    Imports ../pcb/mockup-mod.stl (84 x 79.5): front outputs, DINs and A/B slots 12.5 mm forward, H2 at (80.8, 76.3), the encoder at (73.9, 38.7). Four PJ-320A on the side walls (left CLOCK 39.85 / RESET 46.55, right 53.8 / 60.5): U-slots in 1.8 mm side walls (0.1 from the board), lid keys, one lid cap per wall round both jacks; CLK / RST markings. Box 87.8 x 83.3 x 32.0. 22 checks as required, 6 STLs one body, 0 open edges.
    [jank_box.scad, jank_box_box.stl, jank_box_button_cap.stl, jank_box_knob.stl, jank_box_lid.stl, jank_box_slider_cap.stl]
2026-11-08 fix(box): 0.3 mm side clearance for JLC's ±0.2 outline
    0.3 mm between the board and every wall (sides and front / back; the front and back had 0.1): JLCPCB's outline tolerance is +/-0.2. The jacks' bushings now end 0.1 inside the outer face; each jack slot gets a 10.0 mm x 0.3 mm mouth (also in its key and the lid's edge) so a plug's shoulder still meets the bushing. Box 88.2 x 83.7 x 32.0; DIN faces 3.1 mm in. 22 checks as required, 6 STLs one body, 0 open edges.
    [jank_box.scad, jank_box_box.stl, jank_box_front_test.stl, jank_box_lid.stl]
2026-11-08 feat(pcb): v5c: the jack beside the DIN at a 23 mm pitch, both faces at the wall (modular board 87 x 79.5)
    The user, 2026-11-08/09: the stacked jack was unreachable from outside the box; put the MIDI jack between the DIN plugs, pins not colliding, DIN and jack at the wall. Each output's 3.5 mm jack moves 11.5 mm along the edge into the 2.1 mm gap between two DIN plates (pitch 21.1 -> 23.0); the jack is the surface-mount XKB PJ-320D-B-SMT (C2884940) so nothing of it goes through the board under a DIN body; DIN plate 1.0 behind the edge, jack front 0.5 past it (the box brings the board edge 1.0 inside its outer face). OUT1's DIN at x 17.5 with its jack at the back-left corner (x 6.0) and a sur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
    [bom.csv, jank-pcb-mod.kicad_pcb, jank-pcb-mod.kicad_sch, mockup-mod.stl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]
2026-11-08 feat(box): connectors flush with the outside, the v5c board
    The v5c modular board (87.0 x 79.5, pitch 23.0, MIDI jacks beside their DINs, SW2 surface-mount): on every edge the board's edge is 1.0 mm inside the outer face; the base's wall rises to the board's bottom, the lid's skirt comes down to its top, the board clamped between them. MIDI jack bodies 0.5 inside (0.4 web, bushings 1.5 proud), side jacks 1.0 inside, DIN plates 2.0 inside in a 19.9 x 19.1 window with a 0.5 lip (the footprint puts them 1.0 behind the edge). Box 89.0 x 81.5 x 32.0. 23 checks as required, 7 STLs one body, 0 open edges.
    [jank_box.scad, jank_box_box.stl, jank_box_front_test.stl, jank_box_lid.stl, jank_box_slider_cap.stl, jank_box_slider_cap_smd.stl]
2026-11-09 feat(box): DIN plates slide into grooves in the front and back walls
    The user's rulings (2026-11-09): slots in the wall, no wall behind the DIN body. The base's front and back walls (3.7 deep) carry round each DIN a 0.7 front cheek, a 2.0 slot and a 1.0 back cheek; the plate slides down into it, its face 0.8 inside the base's face (the base 0.2 inside the board's edges, the lid's skirt 1.0 outside them: a 1.2 mm step). Rims 1.3 a side and 2.2 at the far edge, from the body scaled off HOOYA's drawing (17.8 x 17.2 x 13.1). The lip behind the body is gone. 23 checks as required, 7 STLs one body, 0 open edges.
    [jank_box.scad, jank_box_box.stl, jank_box_front_test.stl]
2026-11-09 feat(box): thicker cheeks round the DIN slots
    The user: "can you make the wall thicker?". Front cheek 0.7 -> 1.2 (the base's face moved out 0.5: 0.3 proud of the board's edge, the plate face 1.3 inside it), back cheek 1.0 -> 2.0, posts 4.6 wide x 9.2 deep behind the cheeks between the DIN bodies (0.3 clear), 1.0 mm fillets at the floor. Rims (1.3 sides, 2.2 far edge) and slot play unchanged. Base 89.0 x 80.1, lid 89.0 x 81.5. 23 checks as required, 7 STLs one body, 0 open edges.
    [jank_box.scad, jank_box_box.stl, jank_box_front_test.stl]
2026-11-09 feat(pcb): the 0.96in 128x64 OLED (HS96L03W2C03) instead of the 0.91in
    The user, 2026-11-09: a bigger screen. The 27.3 x 27.8 module floats on its 4-pin header between the opto and BACK/OK, its pin row 3 mm in front of the XIAO (MIDI_TXB's bottom line passes between GND and VCC); only 0805/SOT-23 parts under it. The PCF8574 moves right of it (turned 90; it is 2.65 tall); its right channels now on P2/P3 (south row) and P4..P7 on test pads; SDA/SCL swapped on the XIAO (SDA D8, SCL D9) so the I2C routes nest; the +5V top hop shortened to 34.6..52.3. DRC 0 errors, ERC 0, nets 0 problems, mockup one body. Price of the module not read (0.00 in the BOM).
    [bom.csv, jank-pcb-mod.kicad_pcb, jank-pcb-mod.kicad_sch, mockup-mod.stl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]
2026-11-09 feat(box): the 0.96in screen's window
    The board's 0.96in 128x64 OLED (0172784): the lid's window 22.76 x 11.88 at (38.39, 34.36) over the viewing area (+0.02, as before); four lid posts (dia 4.0, 0.2 above the module's PCB) with dia 2.1 pins 0.6 into the module's holes replace the far-end rib; the check model has the module's PCB with its holes and the glass. 23 checks as required, 7 STLs one body, 0 open edges.
    [jank_box.scad, jank_box_lid.stl]
2026-11-09 feat(pcb): the MIDI resistors as 1206s placed by JLC; the axial pads empty for fixes
    The user, 2026-11-09: the upright resistors are just post fixes. R3k 10 ohm (C17903), the source two 68 ohm 1206s in parallel (R4k + R8k, C17976: 34 ohm, 0.5 W for a mono plug), R9 330 ohm (C17930); R8k in the place of the 33 ohm group's bypass jumper JP2k (removed); the axial footprints stay, not fitted. DRC 0 errors, ERC 0, nets 0 problems.
    [bom.csv, jank-pcb-mod.kicad_pcb, jank-pcb-mod.kicad_sch, mockup-mod.stl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]
2026-11-09 feat(pcb): JLC places everything but the DINs and the XIAO (the default assembly set)
    The user, 2026-11-09: only keep the DINs hand soldered. fab/mod/bom.csv + cpl.csv now hold every top part with an LCSC code, SMD and through hole, plus the MIDI jacks J2..J5 placed at their pads inside J6..J9; fab/mod/smd-only/ keeps the SMD-only set. The jacks' rotation in the CPL is unverified against JLC's preview.
    [bom.csv, jank-pcb-mod.kicad_pcb, mockup-mod.stl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]
2026-11-09 fix(pcb): the review's findings: SMD jack pads mirrored, JLC rotations, in-stock USB-C, basic parts
    An adversarial review (2026-11-09) against JLC's own footprints found: the PJ-320D-B-SMT pads were mirrored (tabs 2/3/4 belong on -x), now fixed; the CPL rotations of SOT-23/-5 (+180), SOT-363, DIP-6, the encoder and the side jacks were wrong, now set from that match; J2..J5's CPL centre is their pads' bounding box, rotation +90. J1 is now the SHOU HAN TYPE-C 6P (C456012, JLC's own footprint via easyeda2kicad; the GCT USB4125 had no JLC stock). JLC refused the HRO 6x6 buttons in every height: OK/BACK (C111992, 9.0 mm) and the OLED module are left to the user. Basic parts instead of extended: R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
    [bom.csv, jank-pcb-mod.kicad_pcb, jank-pcb-mod.kicad_sch, mockup-mod.stl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]
2026-11-09 fix(box): 9.0 mm buttons, the new USB-C
    OK / BACK are the 9.0 mm HRO K2-1102DP-K4SW-04: the button cap's bore floor follows the plunger's top (bore 3.1 deep, was 3.6), its flange, stem and 3.0 mm above the lid unchanged. J1 is the SHOU HAN TYPE-C 6P (C456012): its 8.94 x 3.2 mouth sits inside the 12.5 x 7.0 opening; no collisions. 23 checks as required, 7 STLs one body, 0 open edges.
    [jank_box.scad, jank_box_button_cap.stl, jank_box_lid.stl]
2026-11-09 fix(pcb): the second review: XIAO holes 1.0 mm, side-jack slots 1.5 long, R31 47 ohm, schematic notes
    XIAO header holes 0.889 -> 1.0 mm (0.64 square pins are 0.905 across); PJ-320A tab slots 0.6 x 1.2 -> 0.6 x 1.5 (JLC's footprint for C2884926), pads 1.2 x 2.1; R31 (OUT1's data resistor) 10 -> 47 ohm, C17969 (extended), against a 5 V sender's current into GPIO1 when OUT1 is MIDI IN; the schematic notes now say SDA = D8 = GPIO7, SCL = D9 = GPIO8 and P3 CLK_R, P2 RST_R. DRC 0 errors, ERC 0, nets 0 problems.
    [bom.csv, jank-pcb-mod.kicad_pcb, jank-pcb-mod.kicad_sch, mockup-mod.stl]
2026-11-09 docs: the device page; README says what jank is in Optimist and what this device does
    README: jank is Optimist's group mode (MODE JANK on the FM-1); this repo is the jank device, a standalone ESP32-S3 that lets a computer (Link over its USB network adapter, or USB-MIDI clock) or MIDI / modular gear join a session. docs/device.md: what the device does and has, how the parts fit, what is proved, next. The firmware sections (build, flash, button, control page, protocol, tests, on the air) move to docs/firmware.md. The PCB and box pages link back to the device page.
2026-11-09 chore: ignore the board build outputs
    drc/erc reports, intended-nets.json, the netlist, the unzipped gerbers and the mockup's .scad are recreated by hardware/pcb/make_fab.sh; the gerber zip, bom.csv and cpl.csv stay committed. The two empty square-layout .kicad_pro files are deleted.
2026-11-09 docs: the README leads with jank's novelty: Link with no router
    In MODE JANK the units send open Wi-Fi frames straight to each other on the group's channel (no access point, association, password or host); units on the same GROUP form one Link session. Said first in the README and the device page.
2026-11-09 docs: the README is the device page, with renders; the PCB and box are how to build it
    README leads with Link with no router, then what joins through the device, what it has, two renders (closed, and the lid lifted over the board), status, a Build it section (the PCB, the box, the firmware, the bare XIAO), what is proved, next. docs/device.md folds into it; the PCB, box and firmware pages link back to the README. docs/img/hero.scad renders the pictures from the box and board models.
    [hero.scad]
2026-11-09 fix(box): flush lid and base, round jack holes in both, one hole per USB-C, a registered and snapping joint
    The base's front and back faces come out flush with the lid's (front cheek 1.9, the DIN plates 2.0 in): 89.0 x 81.5 x 32.0 for both parts. A 0.8 rim on the base round the board's edge, 1.6 over its top, the lid's band inside it with 0.2 a side; at the eight 3.5 mm jacks the rim rises to the axis as a tongue holding the lower half of a round 5.4 hole, the lid the upper half. Four 45-degree snap catches (0.35 bump, 0.15 interference); the M2 screws stay the final lock. The XIAO's socket stands 0.5 past the face (its PCB ends at the board's edge): a 9.8 x 4.1 hole split at its axis replac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
    [jank_box.scad, jank_box_box.stl, jank_box_front_test.stl, jank_box_lid.stl]
2026-11-09 fix(box): captured A/B slider tabs
    Each A/B switch gets a captured two-part tab: a block under the lid (flange 6.3 x 8.8, or 6.3 x 7.8 on SW2, 1.0 past the slot on every side over the whole travel, 0.2 under the lid and over the switch body), its pocket on the handle (+0.3 across, +0.1 along the travel), a 4.0 x 2.4 neck through a 4.3 x 4.8 (SW2 4.3 x 4.3) slot, and a 6 x 4 ridged grip pressed onto its post after the lid is on (a one-piece tab cannot pass the slot). New check brace_tabs (4); check_caps and check_drop cover the tabs at both ends of travel; 33 checks pass, 8 STLs one body. The old slider caps' STLs are gone. README, renders (tab, tab_print), the README's hero pictures.
    [jank_box.scad, jank_box_ab_grip.stl, jank_box_ab_tab.stl, jank_box_ab_tab_smd.stl, jank_box_lid.stl, jank_box_slider_cap.stl, jank_box_slider_cap_smd.stl]
2026-11-09 fix(fw): one sector size for the drive's FAT image and the wear levelling (512)
    The FAT image was generated with 4096-byte sectors while the wear levelling ran with 512: macOS saw a 245.8 KB disk with no file system. CONFIG_FATFS_SECTOR_512 makes them match; on a XIAO ESP32-S3 the JANK drive now mounts (read-only) with jank.html (2026-11-11). Builds keep a saved sdkconfig in the scratch folder: delete $JANK_SCRATCH/sdkconfig.<board> once so the default applies.
2026-11-09 feat(fw): scan automatically while alone in jank mode
    The user (2026-11-11): it should scan all the time when not connected. Nobody heard on the home channel for 5 s: a sweep of the other channels every 5 s until a group is heard, which it then joins and keeps (js_pick, as the button). js_auto_step in core with host tests; the UI task checks it every 250 ms and skips it while another sweep holds the radio. LED: magenta per sweep only. Not run on hardware yet.
    [jank_ui.c, jank_ui.h, ui.c]
2026-11-09 feat(fw): two app slots with rollback, updates by copying jank.bin onto the drive and ejecting, optional MIDI update, a bootloader command that hands the USB PHY back
    [partitions_usb.csv]
2026-11-09 feat(page): split the control page into what a player uses and folded details; tempo, play and stop
    The page: the groups heard with a Join button each, the tempo with a new-tempo box, the beat in the bar, Play / Stop, beats a bar, offset, MIDI start / stop and the network on top; counters, peers heard (was units), name, filter, Link peer and download mode under Details. The control line: tempo <bpm>, play, stop change the Link session (jp_set_tempo, jp_set_playing); err no session when alone.
2026-11-09 fix(fw): the update note lives in NVS and says when an image was rolled back
    On the XIAO, a crash image installed from the drive was rolled back as designed but UPDATE.TXT came back empty: the note sat in RTC memory, which the other image's start reuses. The note (slot to run, text) now goes to NVS before the restart; at the start jo_note_at_start says the text if that slot runs, or that the image did not start and the old one is back; it is kept until the new image is confirmed. Measured on the XIAO: rolled-back note, 'installed over MIDI', gone after a plain restart.
    [app.h, drive.c, jank_ota.c, jank_ota.h, ota.c]
2026-11-09 docs: README cut short, two devices (stick and box); control page explains them and the name
2026-11-09 perf(midi): the clock's start bit lands 0.3 us after the tick (sd 0.07 us, worst 2.3 us), measured at the pin
    A test build's probe (JANK_CLOCK_PROBE=1, clkprobe.c) timestamps the TX pad's start bit with the MCPWM capture unit. The alarm now goes 2 us early (interrupt entry + UART), and core 1 runs the clock interrupt alone: TinyUSB's task and interrupt, the USB-MIDI task (priority 24, above Wi-Fi), the USB host tasks, the drive and update tasks, FreeRTOS timers, lwIP and pthreads go to core 0 (before: worst tick 37 us). Also: a new image confirms only after 20 s alive (a crash once the clock started had looped instead of rolling back), the drive is named JANK again after the firmware formats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
    [app.h, clkprobe.c, ctl.c, drive.c, midi.c, ota.c, usb.c]
2026-11-10 feat(midi): the clock offset steps in 10 us (set offset 1.27), not whole ms
    Bench 2026-11-10 (the pin and Live's clock out recorded together through a MOTU into the Fireface, 44.1 kHz, edges interpolated): the stick ran 1.27 ms early against Live, steady, sd 33 us; whole ms could not cancel it. With offset 1.27: mean +42 us, sd 44 us. Same stored field, now in 10 us units (+-10000): a stored 0 stays 0; an old non-zero value reads 100x smaller.
2026-11-10 feat(link): the session clock is a filtered loop with the drift learned, from the fastest round trips; no way out to the internet through the stick
    link.c: each measurement keeps its points' round trips and takes the median of the fastest half; the clock moves a quarter of the way to a measurement and learns the drift between the session's clock and ours (NTP-like gear shift: large gains first); a lone measurement more than 2 ms off is set aside and retried in 2 s, two snap; remeasure every 10 s (Link: 30 s). Simulated (computer 40 ppm fast, 2 min, after settling) the stick's beat error drops from rms 689/743/663 us to 57/24/162 us (steady / uneven / one-way queue), 118 -> 54 us on a busy ne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
    [app.h, bridge.c, ctl.c, jank_net.c, jank_net.h, main.c]
2026-11-10 feat(link): the drift is the slope through the last 8 measurements; settled steps of 1/8; re-checks of a slower member leave the clock alone
    On the XIAO (Live on USB, an FM-1 on the air, 2 min after 100 s settling): the single-step drift filter had learned -20 ppm from a restart's first measurements and took minutes to unlearn it (stick vs Live sd 270-320 us); with the slope it holds -14 ppm and the stick sits within 10-30 us (sd) of Live inside every 10 s window. Over minutes the stick and the FM-1 step together against Live every ~30 s: Live's own Link remeasurement (Ableton's 30 s step), the reference itself. Simulation: rms 13/39/84 us (steady/uneven/busy) against 689/743/118 for Link's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
2026-11-10 docs(midi): the jam chain with the filtered Link clock on both the stick and an FM-1: 27 us between them
